mhamann/hdmi-mipi-bridge/production/reports/renders/bottom.png

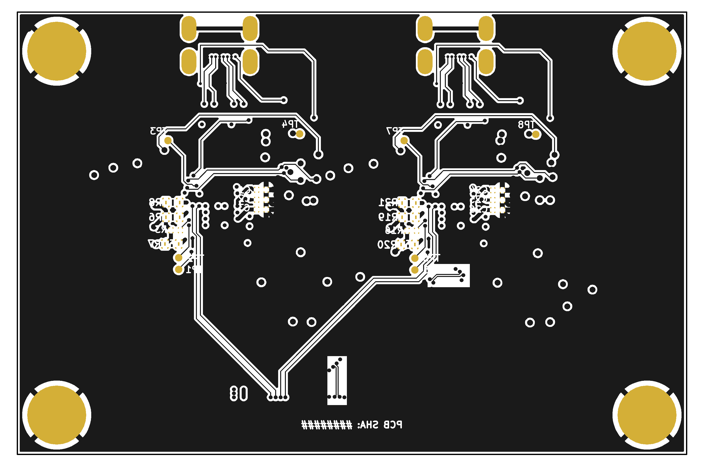
production/reports/renders/bottom.png
