mhamann/hdmi-mipi-bridge/production/reports/renders/ch1_connector_B.Cu.png

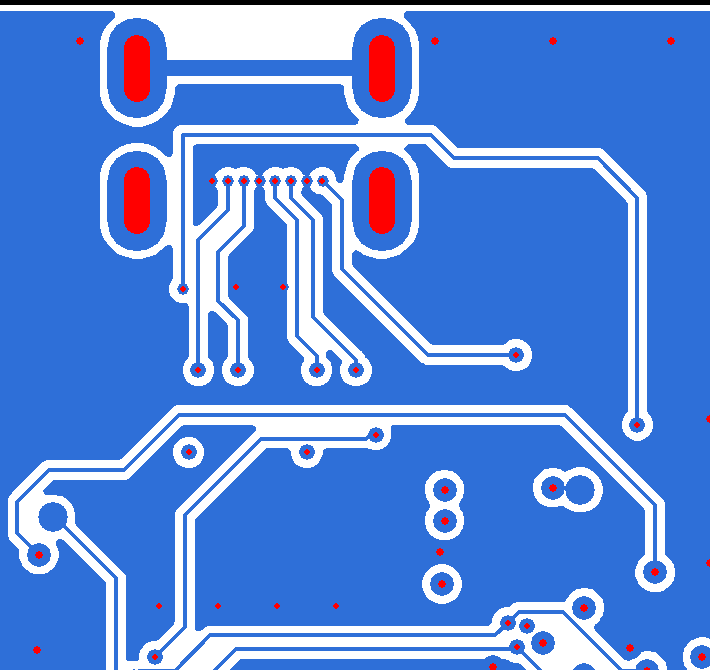
production/reports/renders/ch1_connector_B.Cu.png
