mhamann/hdmi-mipi-bridge/production/reports/renders/ch1_connector_F.Cu.png

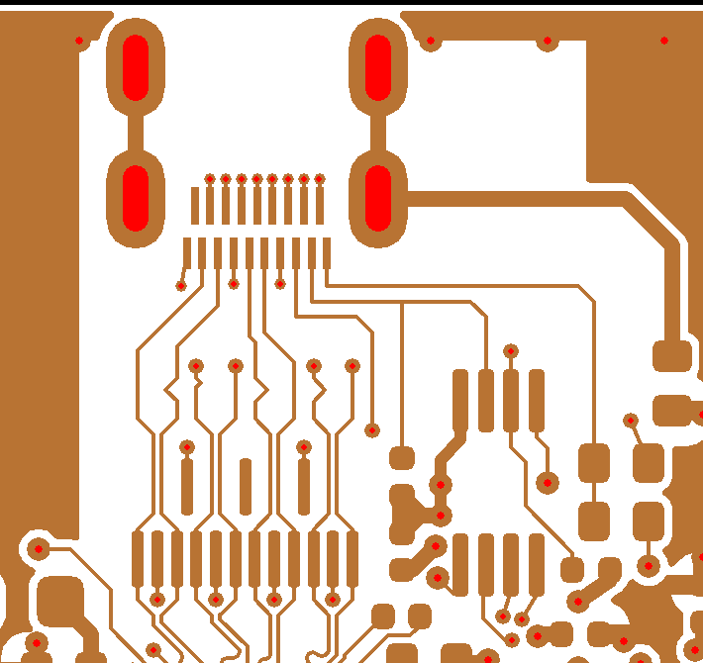
production/reports/renders/ch1_connector_F.Cu.png
