mhamann/hdmi-mipi-bridge/production/reports/renders/ch1_connector_F.Mask.png

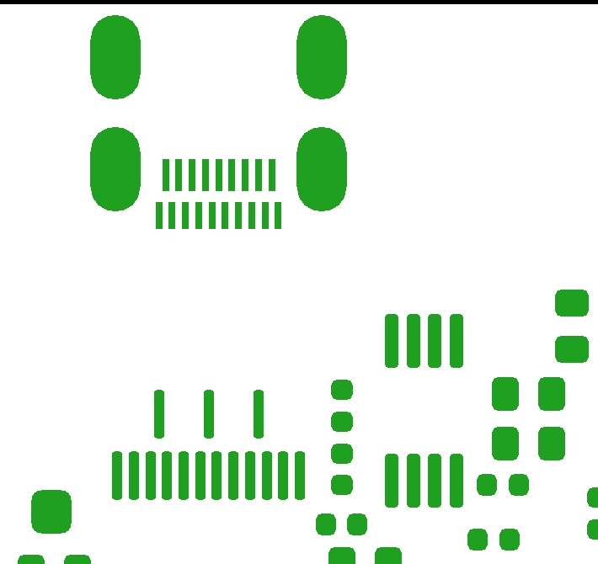
production/reports/renders/ch1_connector_F.Mask.png
