mhamann/hdmi-mipi-bridge/production/reports/renders/ch1_routing_B_labelled.png

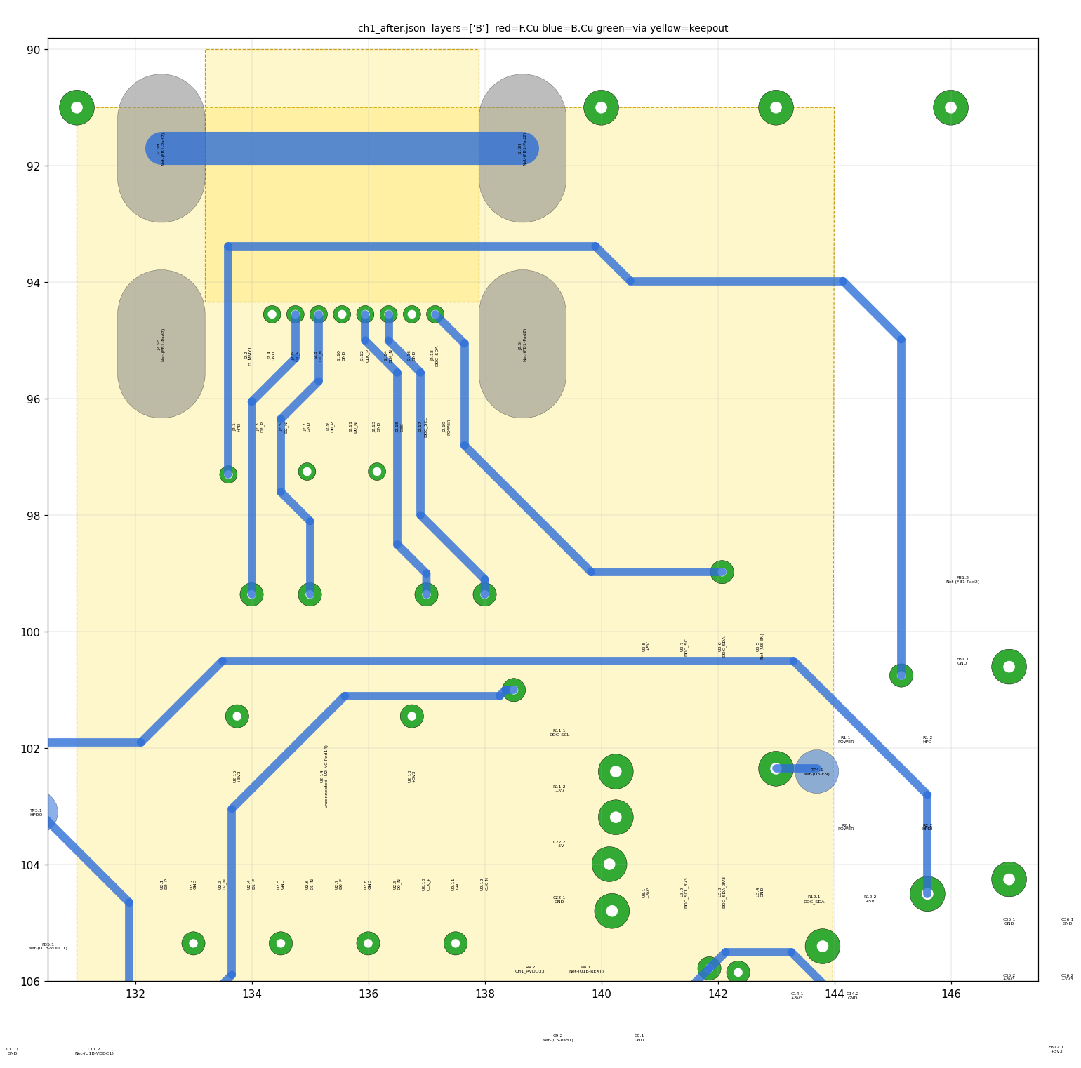
production/reports/renders/ch1_routing_B_labelled.png
