mhamann/hdmi-mipi-bridge/production/reports/renders/ch1_routing_F_labelled.png

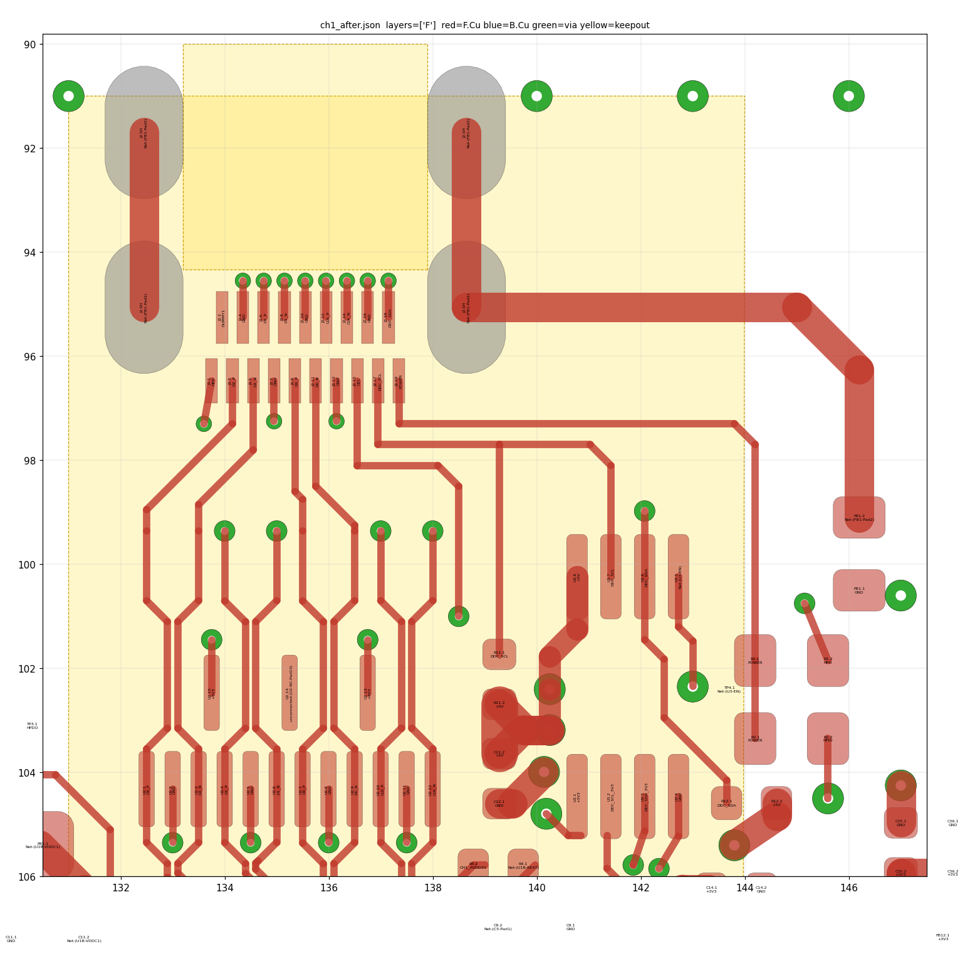
production/reports/renders/ch1_routing_F_labelled.png
