mhamann/hdmi-mipi-bridge/production/reports/renders/top.png

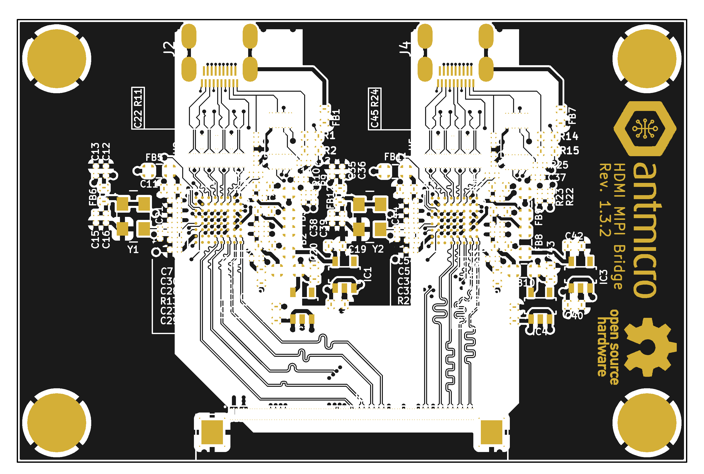
production/reports/renders/top.png
