mhamann/hdmi-mipi-bridge/production/jlcpcb/BOM-hdmi-mipi-bridge.csv

Comment | Designator | Footprint | LCSC Part # | Qty | Manufacturer | MPN | Ordered part | Notes
C_100n_0402 | C1,C2,C3,C12,C14,C15,C22,C24,C25,C26,C27,C28,C29,C30,C31,C32,C33,C34,C35,C37,C38,C45 | C_0402_1005Metric | C85960 | 22 | Murata | GRM155R61H104KE14D | Murata GRM155R61H104KE14D
C_470p_0402 | C4,C5,C6,C7,C47,C48,C49,C50 | C_0402_1005Metric | C106207 | 8 | Yageo | CC0402KRX7R9BB471 | Yageo CC0402KRX7R9BB471 | changed from Walsin 0402B471K250CT (out of stock)
C_4u7_0603 | C8,C9,C10,C11,C51,C52,C53,C54 | C_0603_1608Metric | C329940 | 8 | TDK | C1608X5R1V475KT000E | TDK C1608X5R1V475KT000E | changed from TDK C1608X5R1V475M080AC (out of stock)
C_47p_0402 | C13,C16,C21,C23,C36,C39,C44,C46 | C_0402_1005Metric | C2169042 | 8 | KEMET | C0402C470J5GACTU | KEMET C0402C470J5GACTU
C_10u_0603 | C17,C18,C19,C20,C40,C41,C42,C43 | C_0603_1608Metric | C77044 | 8 | Murata | GRM188R61A106KE69D | Murata GRM188R61A106KE69D
FB_120Z_3A_Murata-BLM18SG_0603 | FB1,FB7 | FB_0603_1608Metric | C113030 | 2 | Murata | BLM18SG121TN1D | Murata BLM18SG121TN1D
FB_1kZ_0.8A_WE-CBF_0805 | FB2,FB3,FB4,FB5,FB8,FB9,FB10,FB11 | FB_0805_2012Metric | C2661448 | 8 | Würth Elektronik | 742792096 | Wurth 742792096
FB_600Z_0.5A_Murata-BLM18AG_0603 | FB6,FB12 | FB_0603_1608Metric | C19330 | 2 | Murata | BLM18AG601SN1D | Murata BLM18AG601SN1D
TLV73325PDBVR | IC1,IC3 | SOT-23-5 | C882825 | 2 | Texas Instruments | TLV73325PDBVR | TI TLV73325PDBVR | reel code of original TLV73325PDBVT
TLV74312PDBVR | IC2,IC4 | SOT-23-5 | C485149 | 2 | Texas Instruments | TLV74312PDBVR | TI TLV74312PDBVR | changed from TLV73312PDBVT (pin-compatible TLV743P, 36 in stock)
HDMI-D_Molex_467651001 | J2,J4 | HDMI_Micro-D_Molex_46765-1xxx | C563878 | 2 | Molex | 467651001 | Molex 467651001 micro-HDMI | NEW: replaces HDMI-A Molex 471511001
Conn_FFC_WE_68715014022 | J6 | Conn_FFC_WE_68715014x22 | C5566958 | 1 | Würth Elektronik | 68715014022 | Wurth 68715014022 | lowest stock on BOM (17)
R_0R_0603 | R1,R2,R5,R6,R7,R8,R14,R15,R18,R19,R20,R21 | R_0603_1608Metric | C512908 | 12 | Bourns | CR0603-J/-000ELF | Bourns CR0603-J/-000ELF
R_10k_0402 | R3,R9,R10,R11,R12,R16,R22,R23,R24,R25 | R_0402_1005Metric | C202396 | 10 | Bourns | CR0402-FX-1002GLF | Bourns CR0402-FX-1002GLF
R_2k_0402 | R4,R17 | R_0402_1005Metric | C4109 | 2 | UNI-ROYAL | 0402WGF2001TCE | UNI-ROYAL 0402WGF2001TCE | JLC basic; changed from Bourns CR0402-FX-2001GLF
R_22R_0402 | R13,R26 | R_0402_1005Metric | C25092 | 2 | UNI-ROYAL | 0402WGF220JTCE | UNI-ROYAL 0402WGF220JTCE | JLC basic; changed from Bourns CR0402-FX-22R0GLF
Spacer_Drill4.25mm_H6mm_SMTSO2560CTJ | SP1,SP2,SP3,SP4 | Spacer_Drill4.25mm_H6mm_SMTSO2560CTJ | C2916361 | 4 | Sinhoo | SMTSO2560CTJ | Sinhoo SMTSO2560CTJ | changed from Wurth 9774060151R; hole now 4.25 mm
TC358743XBG | U1,U4 | BGA-64_8x8_6.0x6.0mm | C3008606 | 2 | Toshiba | TC358743XBG | Toshiba TC358743XBG(EL,NOK) | tape&reel ordering code of TC358743XBG
TPD8S009DSMR | U2,U5 | R-PDSO-N15 | C471873 | 2 | Texas Instruments | TPD8S009DSMR | TI TPD8S009DSMR
PCA9517ADP | U3,U6 | MSOP-8_3x3mm_P0.65mm | C80799 | 2 | NXP | PCA9517ADP,118 | NXP PCA9517ADP,118 | changed from PCA9517ATP (HWSON8, 4 in stock); MSOP-8
Oscillator_27MHz_HELE_SSI027000E3CH | Y1,Y2 | Oscillator_SMD_TXC_7C_5x3.2x1.2mm | C254224 | 2 | HELE (Harmony Electronics) | SSI027000E3CH | HELE SSI027000E3CH | changed from TXC 7C-27.000MBB-T (out of stock)
