mhamann/hdmi-mipi-bridge/production/reports/schematic.pdf

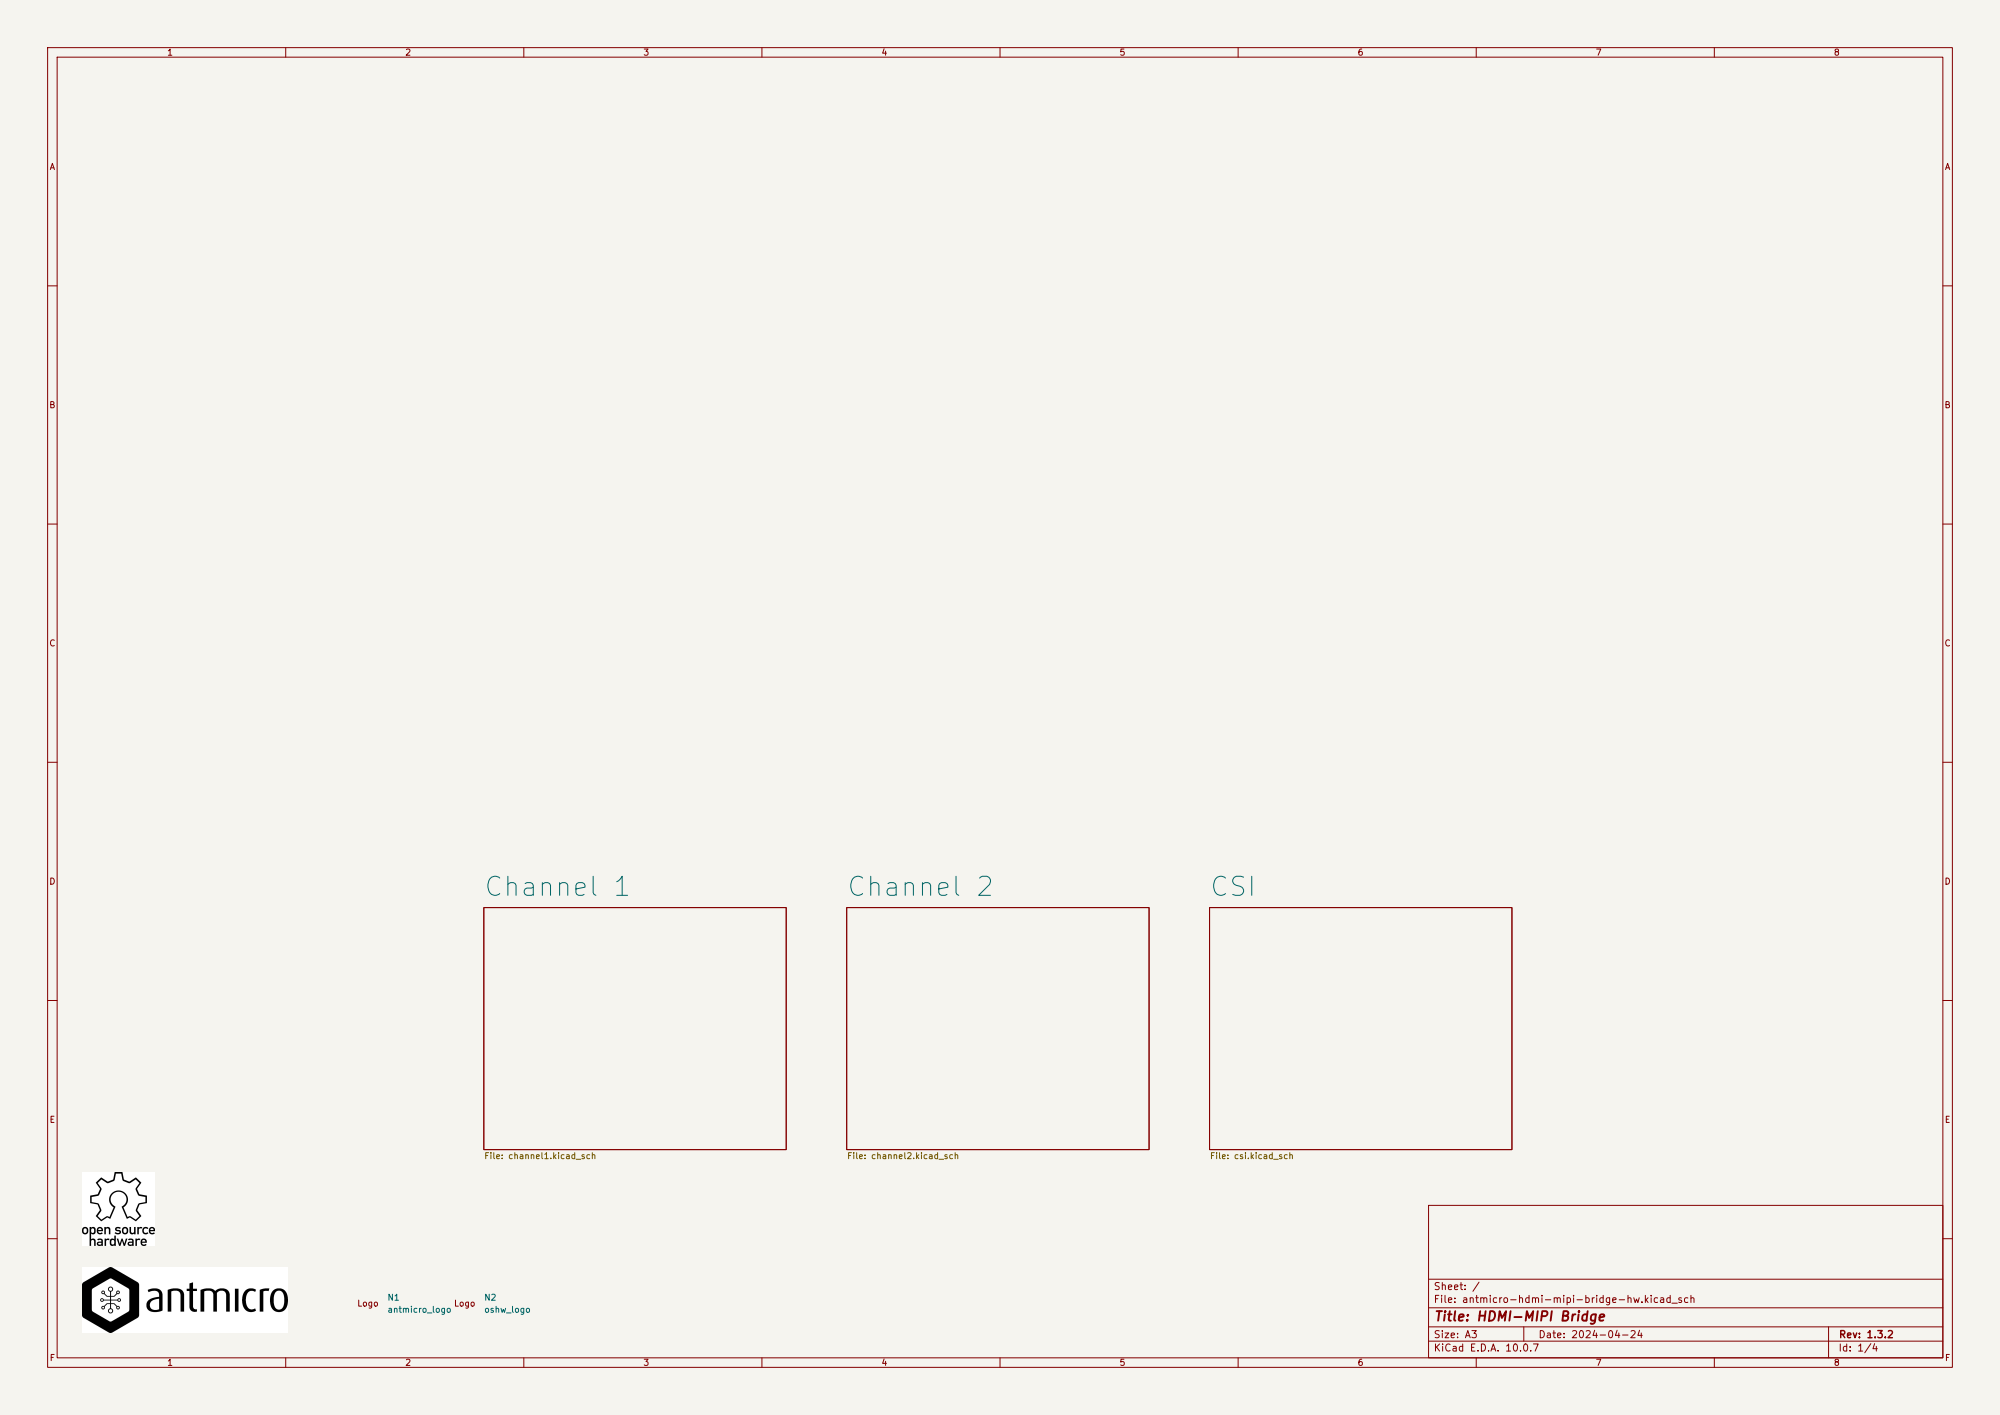
[picture p8: page 1]

Sheet: /
File: antmicro-hdmi-mipi-bridge-hw.kicad_sch
Title: HDMI-MIPI Bridge

Size: A3 | Rev: 1.3.2 | F Date: 2024-04-24
KiCad E.D.A. 10.0.7 | Id: 1/4

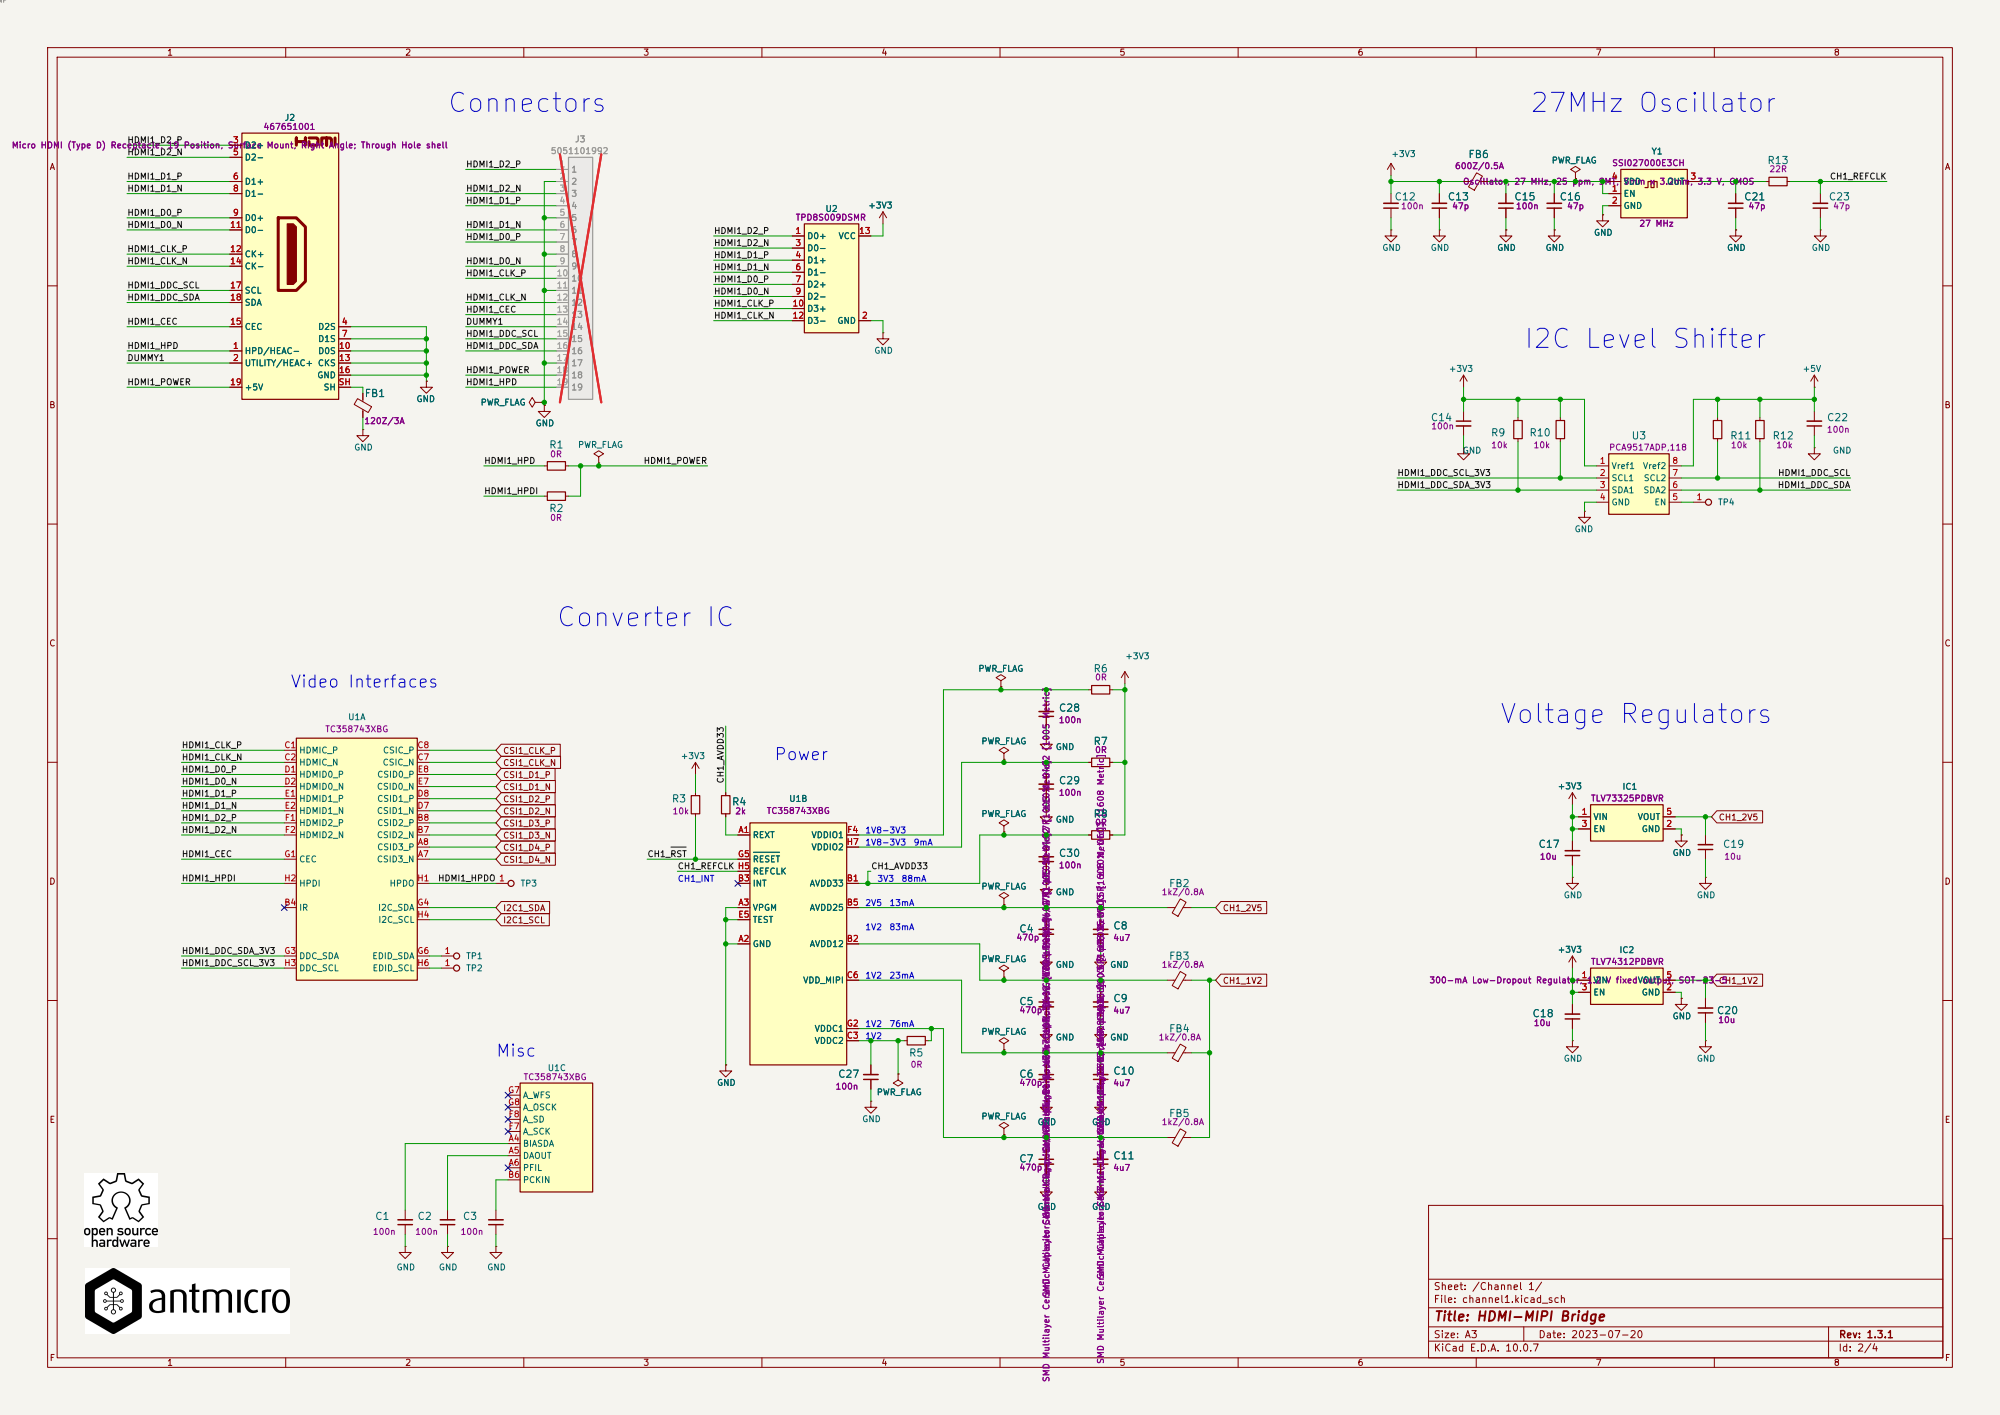
[picture p9: page 2]

PWR_FLAGC4 SMD Multilayer Ceramic Capacitor, General Purpose, 470 pF, 50 V, X7R, ±10%, 0402 [1005 Metric]

GND C5 SMD Multilayer Ceramic Capacitor, General Purpose, 470 pF, 50 V, X7R, ±10%, 0402 [1005 Metric]

300-mA Low-Dropout Regulator, 1.2 V fixed output, SOT-23-5

BIASDA A4 DAOUT A5 PFIL A6 PCKIN B6

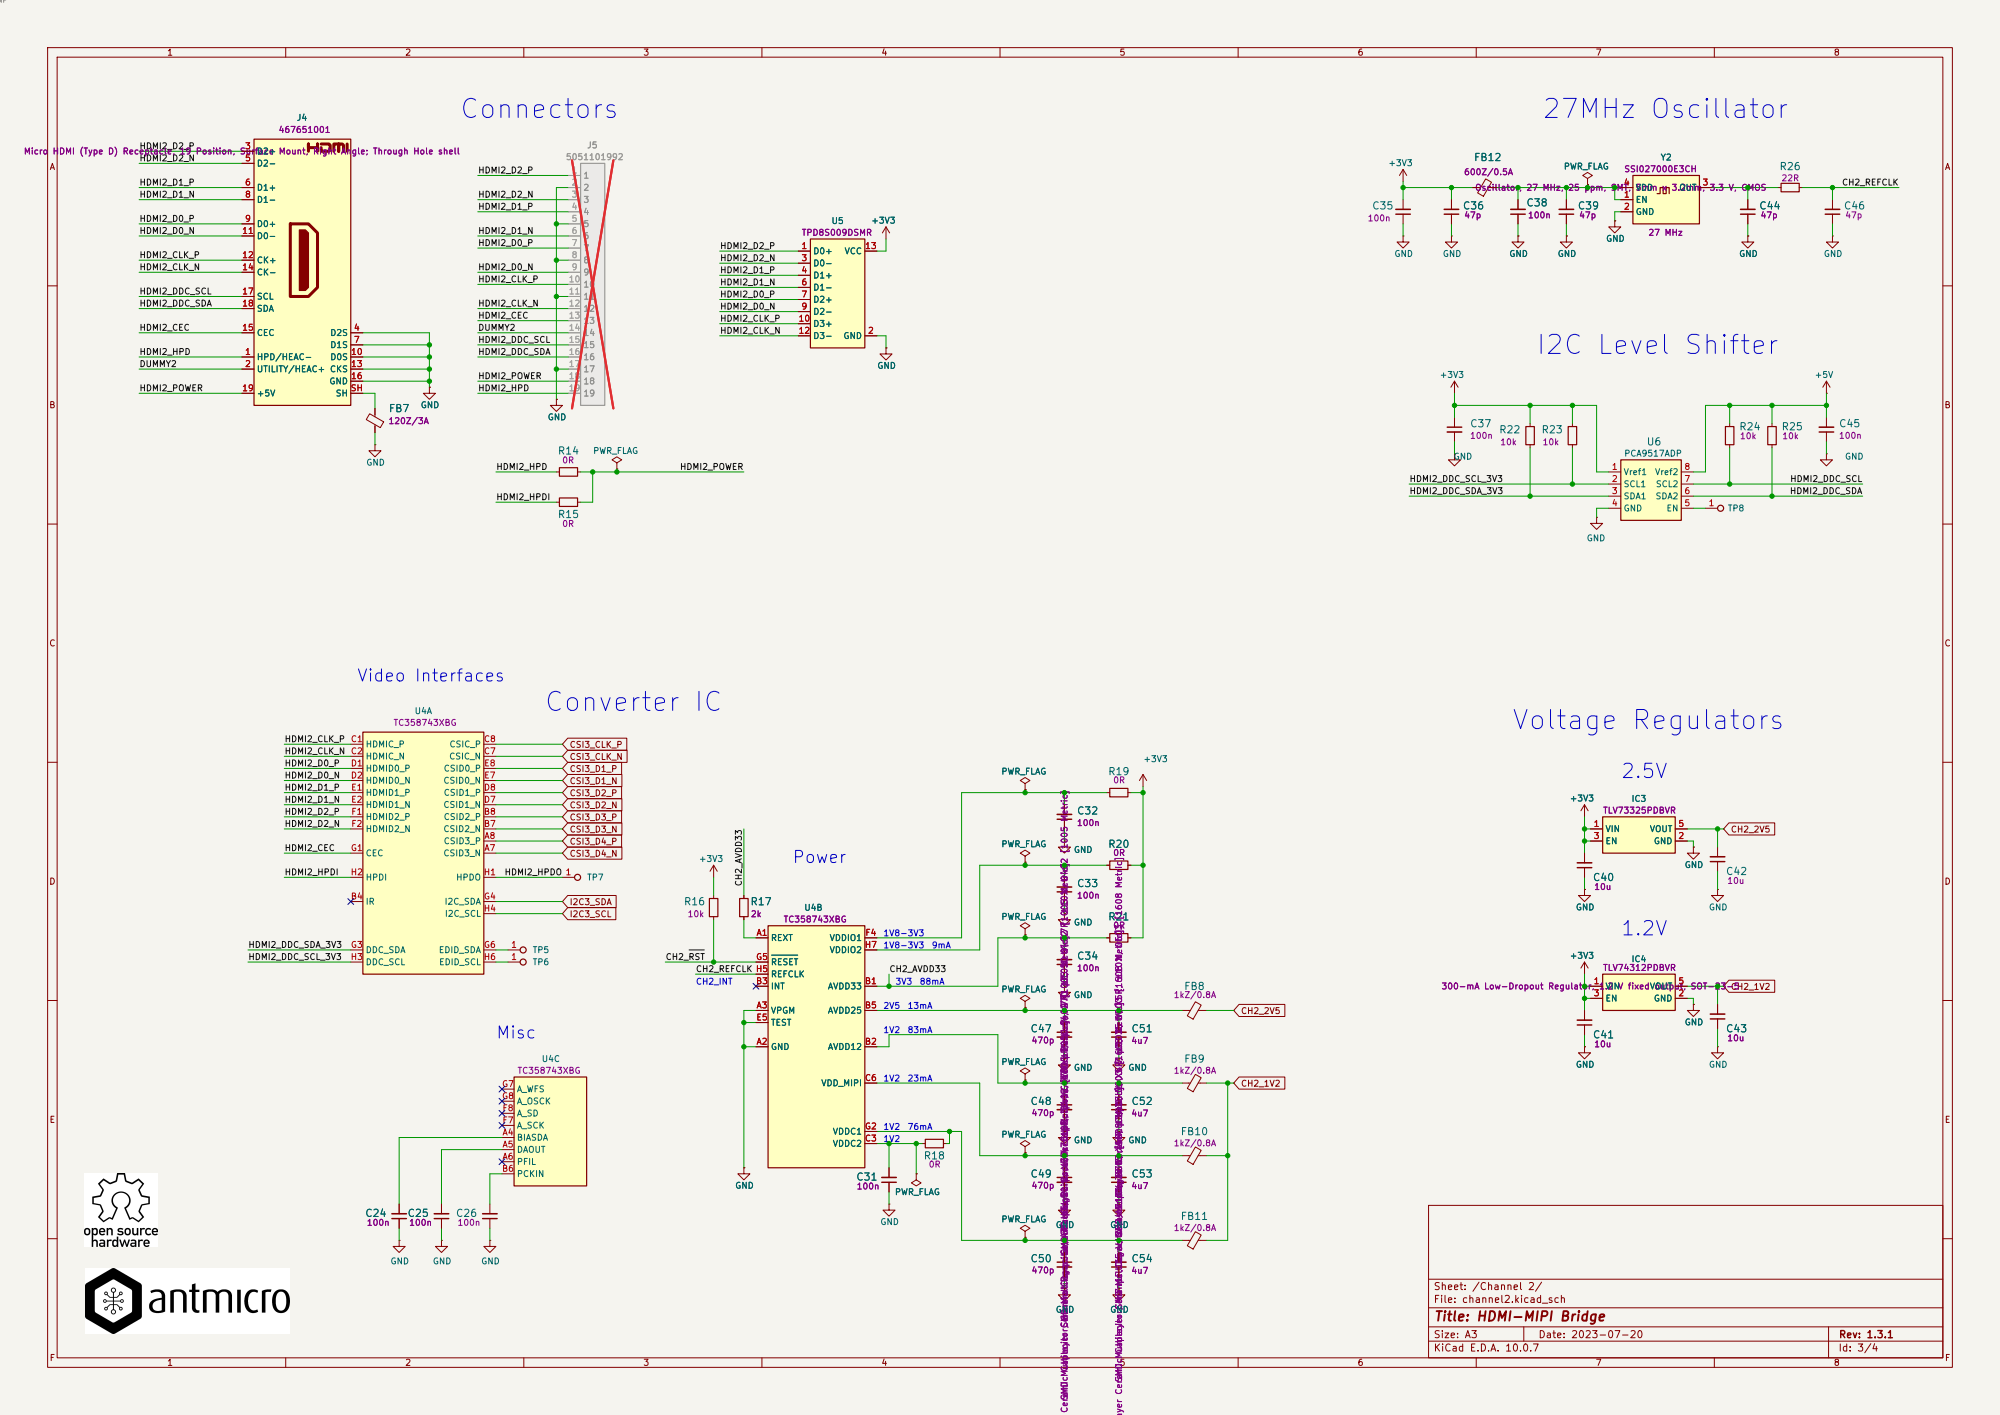
[picture p10: page 3]

J4 Micro HDMI (Type D) Receptacle, 19 Position, Surface Mount, Right Angle; Through Hole shell 467651001

100n C49 SMD Multilayer Ceramic Capacitor, General Purpose, 470 pF, 50 V, X7R, ±10%, 0402 [1005 Metric]
10k C48 SMD Multilayer Ceramic Capacitor, General Purpose, 470 pF, 50 V, X7R, ±10%, 0402 [1005 Metric]

300-mA Low-Dropout Regulator, 1.2 V fixed output, SOT-23-5

100n BIASDA A4 DAOUT A5 PFIL A6 PCKIN B6

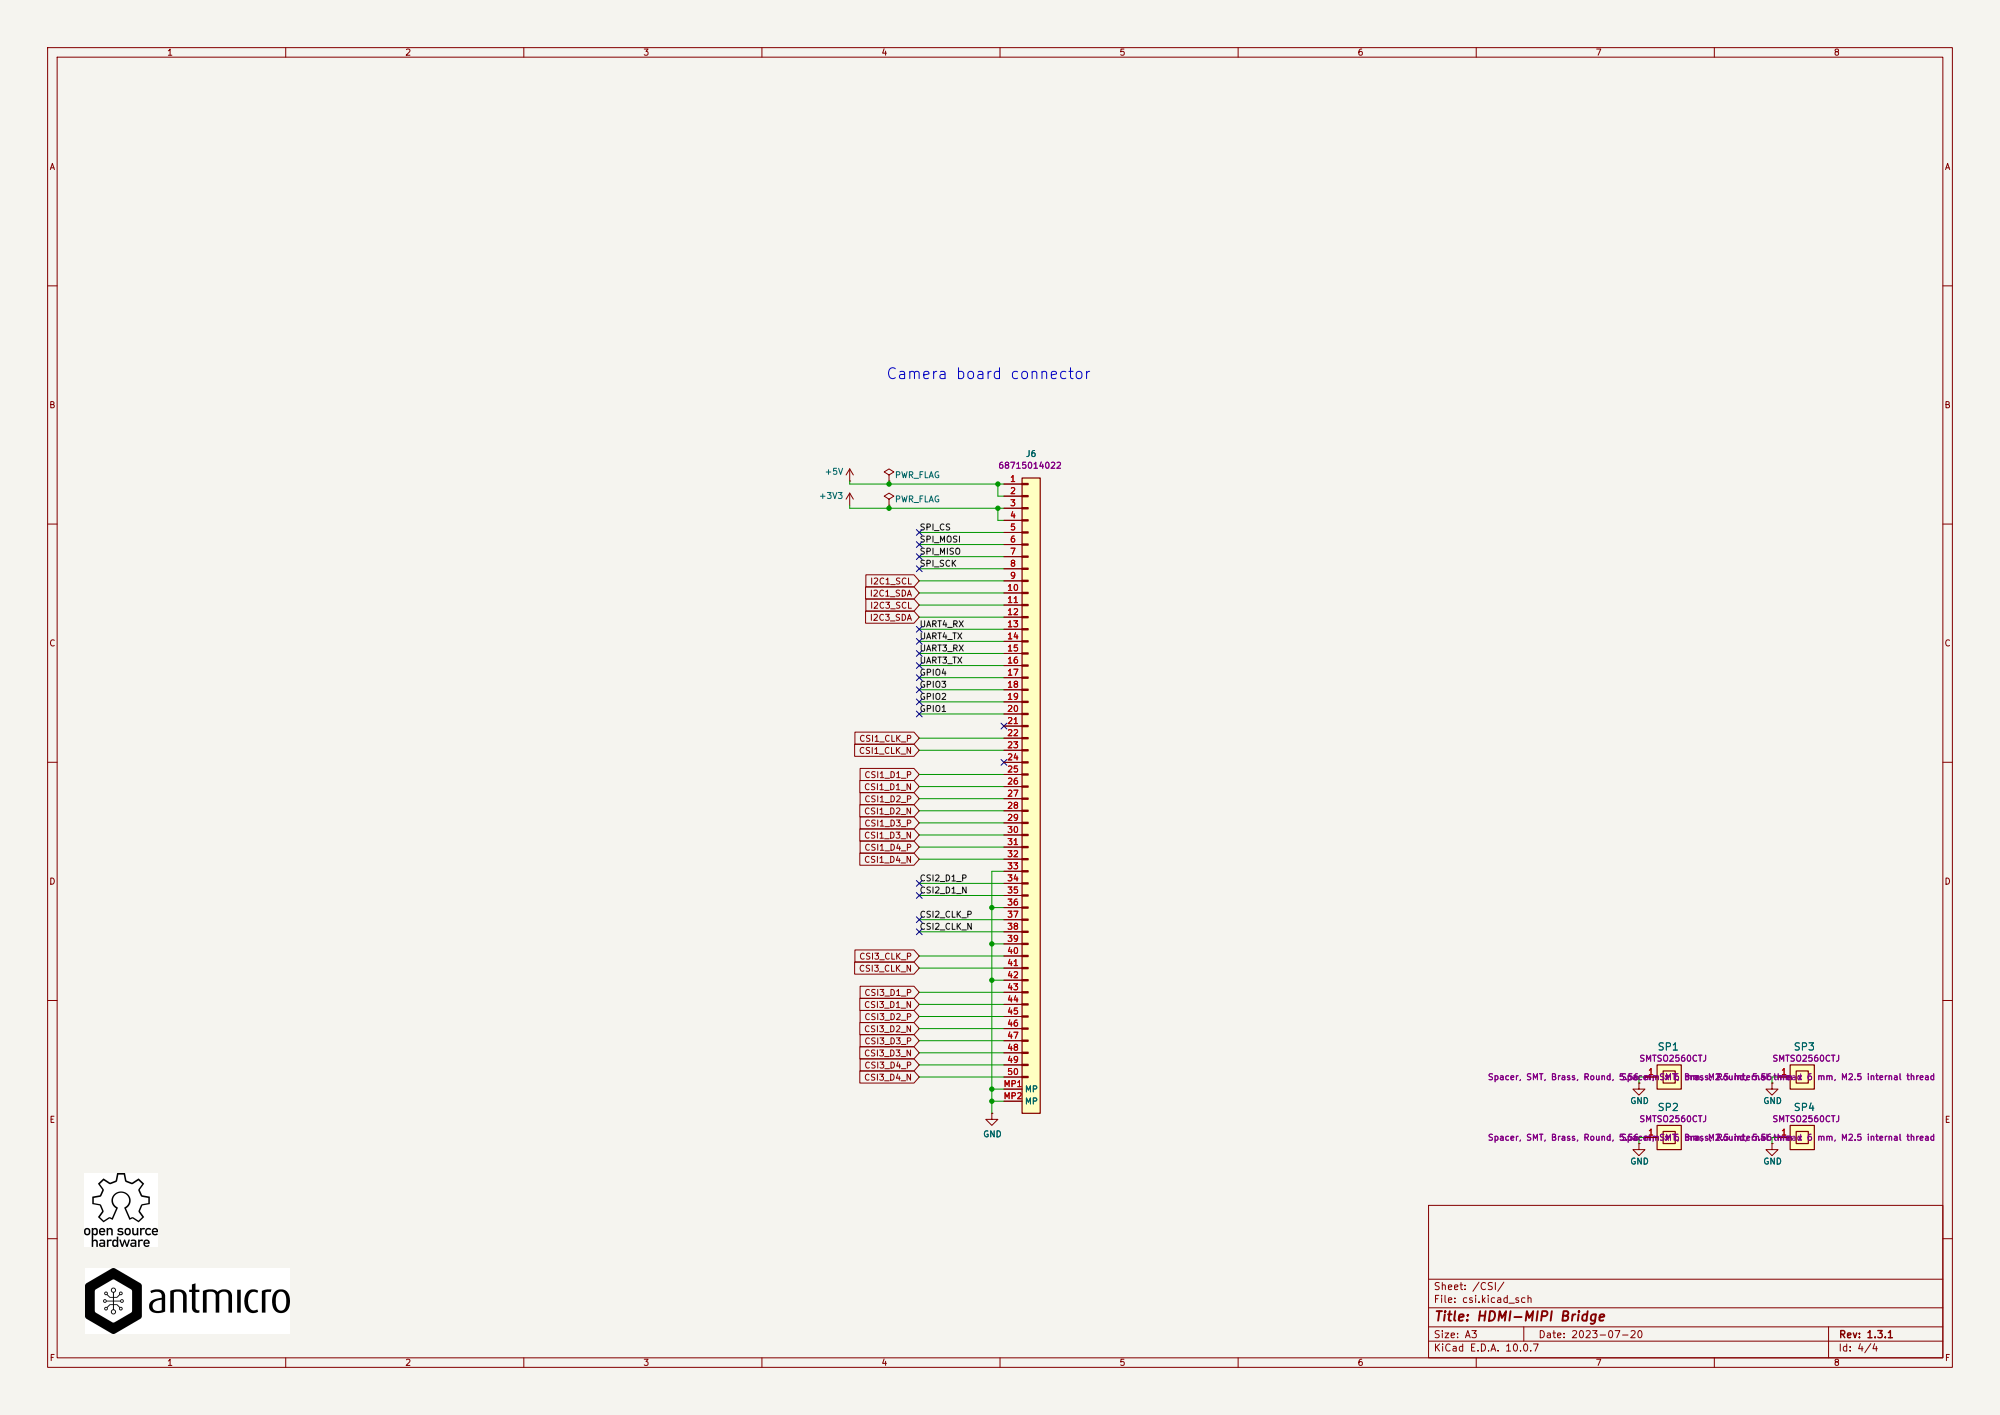
[picture p11: page 4]
