mhamann/hdmi-mipi-bridge/antmicro-hdmi-mipi-bridge-hw.kicad_pcb

## KiCad design antmicro-hdmi-mipi-bridge-hw.kicad_pcb (2026-10-27)

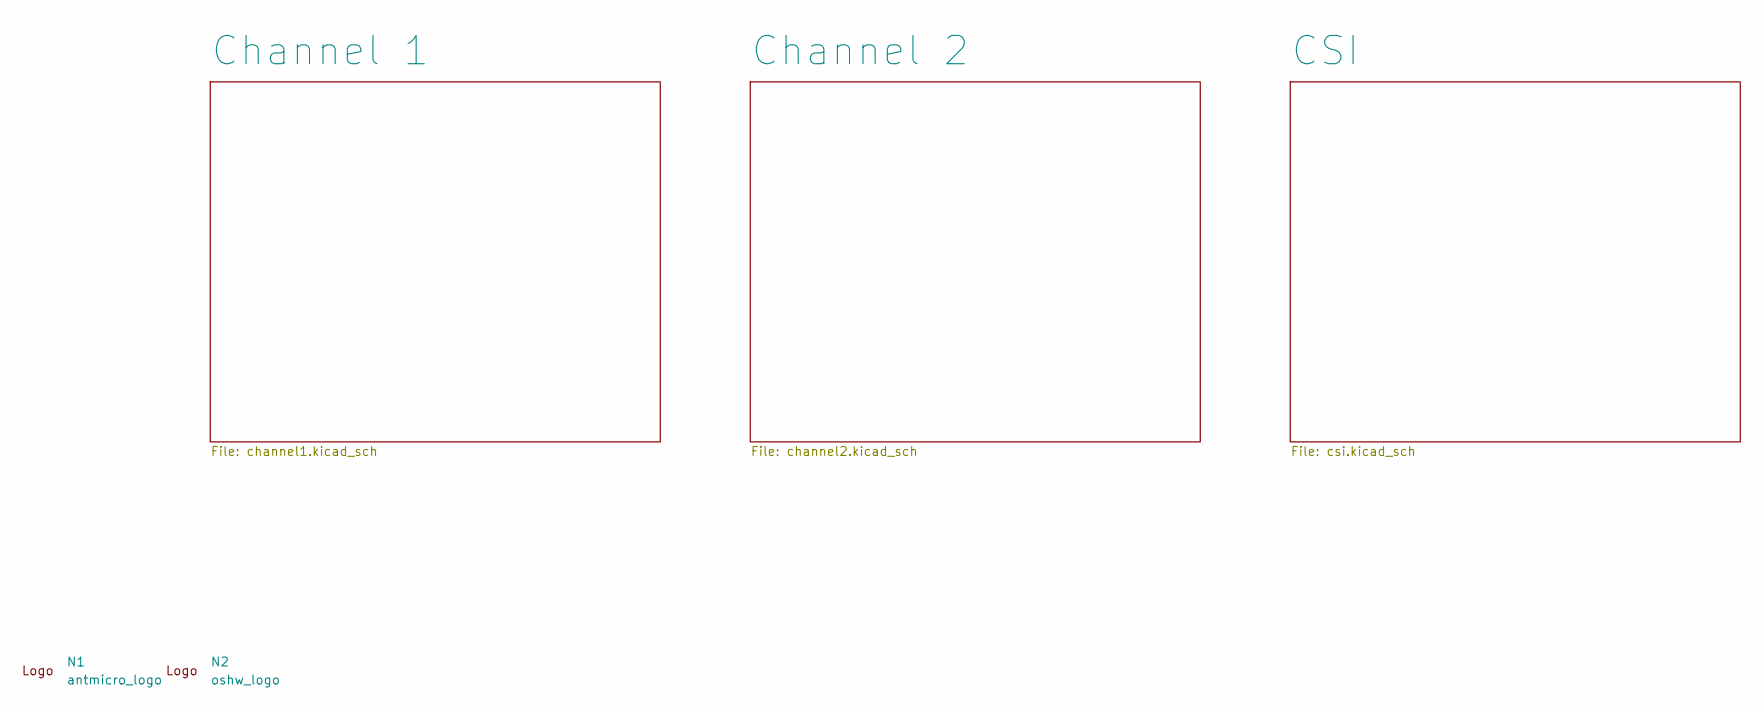
[picture p12: schematic antmicro-hdmi-mipi-bridge-hw.kicad_sch, HDMI-MIPI Bridge]

Parts:
N1: antmicro_logo; antmicro-logo_scaled_20mm_mask
N2: oshw_logo; OSHW-Logo_7.5x8mm_Mask

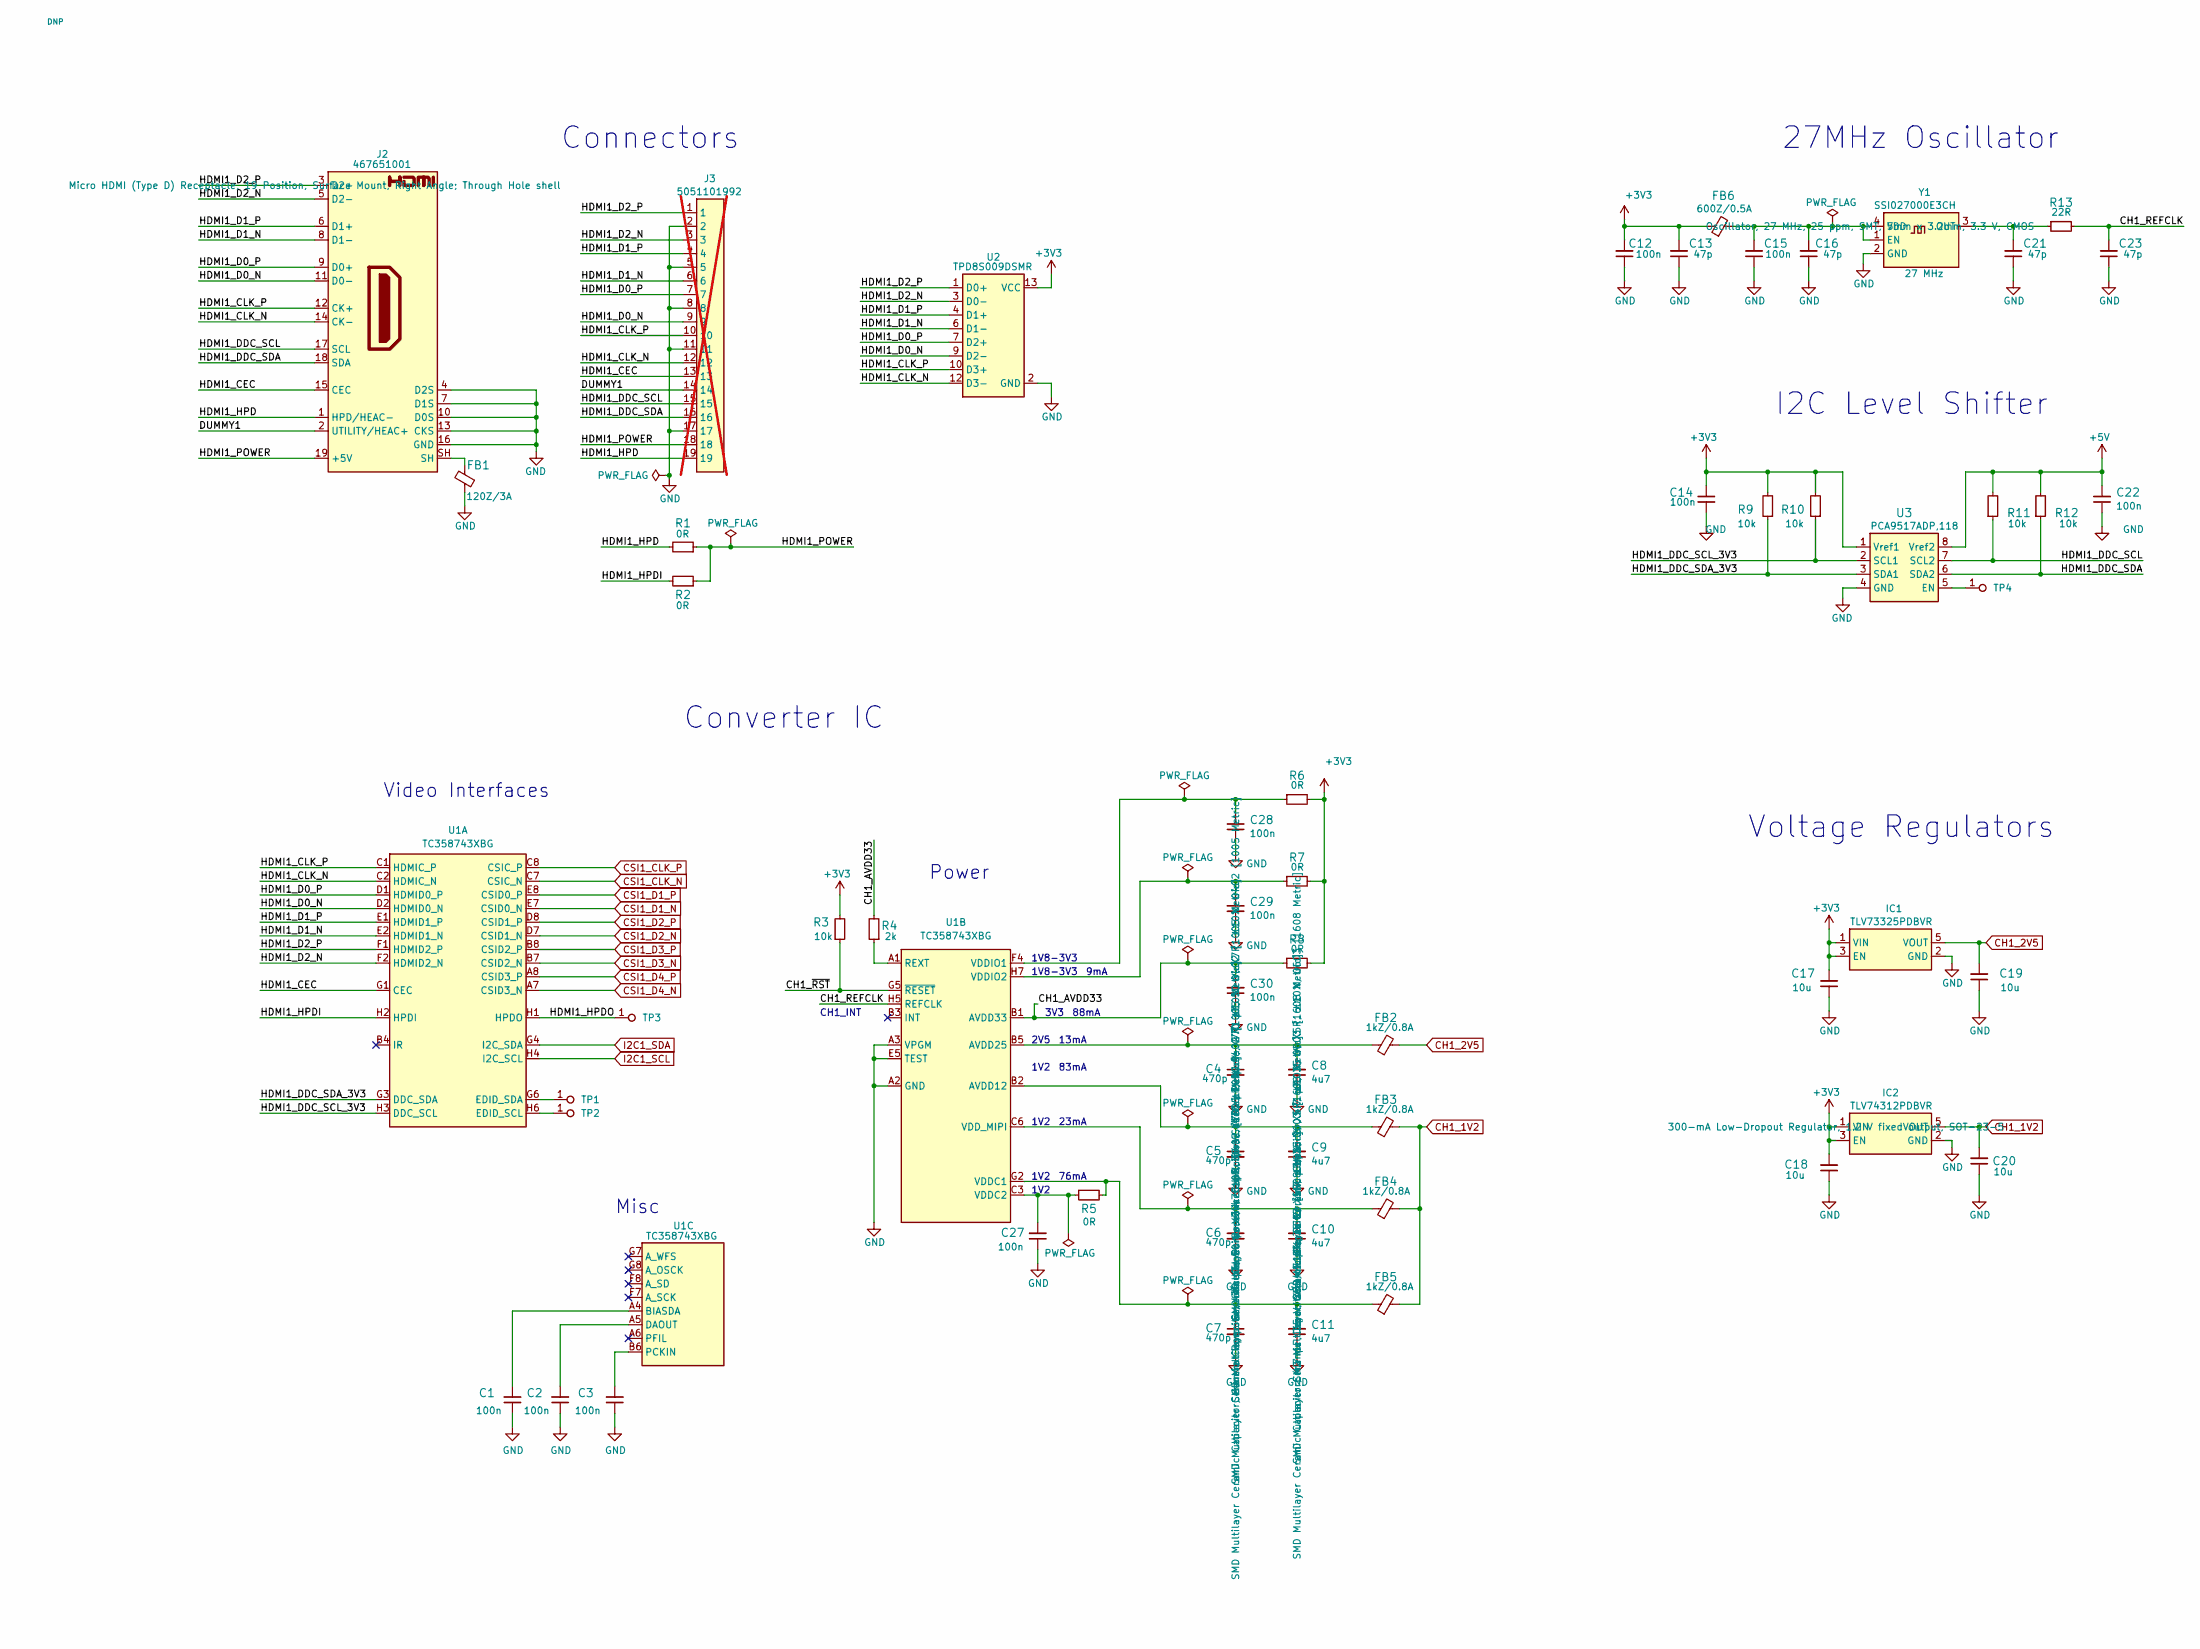
[picture p13: schematic channel1.kicad_sch, HDMI-MIPI Bridge]

Parts:
C1, C2, C3, C12, C14, C15, C22, C27, C28, C29, C30: C_100n_0402; C_0402_1005Metric; Voltage 50V; MPN GRM155R61H104KE14D
C4, C5, C6, C7: C_470p_0402; C_0402_1005Metric; MPN CC0402KRX7R9BB471
C8, C9, C10, C11: C_4u7_0603; C_0603_1608Metric; MPN C1608X5R1V475KT000E
C13, C16, C21, C23: C_47p_0402; C_0402_1005Metric; MPN C0402C470J5GACTU
C17, C18, C19, C20: C_10u_0603; C_0603_1608Metric; MPN GRM188R61A106KE69D
FB1: FB_120Z_3A_Murata-BLM18SG_0603; FB_0603_1608Metric; MPN BLM18SG121TN1D
FB2, FB3, FB4, FB5: FB_1kZ_0.8A_WE-CBF_0805; FB_0805_2012Metric; MPN 742792096
FB6: FB_600Z_0.5A_Murata-BLM18AG_0603; FB_0603_1608Metric; MPN BLM18AG601SN1D
IC1: TLV73325PDBVR; SOT-23-5; MPN TLV73325PDBVR
IC2: TLV74312PDBVR; SOT-23-5; MPN TLV74312PDBVR
J2: HDMI-D_Molex_467651001; HDMI_Micro-D_Molex_46765-1xxx; MPN 467651001
J3: 5051101992; MPN 5051101992; not fitted
R1, R2, R5, R6, R7, R8: R_0R_0603; R_0603_1608Metric; MPN CR0603-J/-000ELF
R3, R9, R10, R11, R12: R_10k_0402; R_0402_1005Metric; Tolerance 1%; MPN CR0402-FX-1002GLF
R4: R_2k_0402; R_0402_1005Metric; Tolerance 1%; MPN 0402WGF2001TCE
R13: R_22R_0402; R_0402_1005Metric; Tolerance 1%; MPN 0402WGF220JTCE
TP1, TP2, TP3, TP4: TP_0.75mm_SMD; TP_SMD_0.75mm
U1: TC358743XBG; BGA-64_8x8_6.0x6.0mm; MPN TC358743XBG
U2: TPD8S009DSMR; R-PDSO-N15; MPN TPD8S009DSMR
U3: PCA9517ADP; MSOP-8_3x3mm_P0.65mm; MPN PCA9517ADP,118
Y1: Oscillator_27MHz_HELE_SSI027000E3CH; Oscillator_SMD_TXC_7C_5x3.2x1.2mm; MPN SSI027000E3CH

Connections:
+3V3: C12.2, C13.2, C14.1, C17.2, C18.2, FB6.1, IC1.1 (VIN), IC1.3 (EN), IC2.1 (VIN), IC2.3 (EN), R3.2, R6.2, R7.2, R8.2, R9.2, R10.2, U2.13 (VCC), U2.15 (VCC), U3.1 (Vref1); also elsewhere on the board
+5V: C22.2, R11.2, R12.2, U3.8 (Vref2); also elsewhere on the board
/Channel 1/CH1_AVDD33: C30.2, R4.2, R8.1, U1.B1 (AVDD33), U1.F3 (AVDD33)
/Channel 1/CH1_REFCLK: C23.2, R13.2, U1.H5 (REFCLK)
/Channel 1/CH1_~RST: R3.1, U1.G5 (~RESET)
/Channel 1/DUMMY1: J2.2 (UTILITY/HEAC+), J3.14
/Channel 1/HDMI1_CEC: J2.15 (CEC), J3.13, U1.G1 (CEC)
/Channel 1/HDMI1_CLK_N: J2.14 (CK-), J3.12, U1.C2 (HDMIC_N), U2.12 (D3-)
/Channel 1/HDMI1_CLK_P: J2.12 (CK+), J3.10, U1.C1 (HDMIC_P), U2.10 (D3+)
/Channel 1/HDMI1_D0_N: J2.11 (D0-), J3.9, U1.D2 (HDMID0_N), U2.9 (D2-)
/Channel 1/HDMI1_D0_P: J2.9 (D0+), J3.7, U1.D1 (HDMID0_P), U2.7 (D2+)
/Channel 1/HDMI1_D1_N: J2.8 (D1-), J3.6, U1.E2 (HDMID1_N), U2.6 (D1-)
/Channel 1/HDMI1_D1_P: J2.6 (D1+), J3.4, U1.E1 (HDMID1_P), U2.4 (D1+)
/Channel 1/HDMI1_D2_N: J2.5 (D2-), J3.3, U1.F2 (HDMID2_N), U2.3 (D0-)
/Channel 1/HDMI1_D2_P: J2.3 (D2+), J3.1, U1.F1 (HDMID2_P), U2.1 (D0+)
/Channel 1/HDMI1_DDC_SCL: J2.17 (SCL), J3.15, R11.1, U3.7 (SCL2)
/Channel 1/HDMI1_DDC_SCL_3V3: R10.1, U1.H3 (DDC_SCL), U3.2 (SCL1)
/Channel 1/HDMI1_DDC_SDA: J2.18 (SDA), J3.16, R12.1, U3.6 (SDA2)
/Channel 1/HDMI1_DDC_SDA_3V3: R9.1, U1.G3 (DDC_SDA), U3.3 (SDA1)
/Channel 1/HDMI1_HPD: J2.1 (HPD/HEAC-), J3.19, R1.2
/Channel 1/HDMI1_HPDI: R2.2, U1.H2 (HPDI)
/Channel 1/HDMI1_HPDO: TP3.1, U1.H1 (HPDO)
/Channel 1/HDMI1_POWER: J2.19 (+5V), J3.18, R1.1, R2.1
CH1_1V2: C20.2, FB3.2, FB4.2, FB5.2, IC2.5 (VOUT)
CH1_2V5: C19.2, FB2.2, IC1.5 (VOUT)
CSI1_CLK_N: U1.C7 (CSIC_N); also elsewhere on the board
CSI1_CLK_P: U1.C8 (CSIC_P); also elsewhere on the board
CSI1_D1_N: U1.E7 (CSID0_N); also elsewhere on the board
CSI1_D1_P: U1.E8 (CSID0_P); also elsewhere on the board
CSI1_D2_N: U1.D7 (CSID1_N); also elsewhere on the board
CSI1_D2_P: U1.D8 (CSID1_P); also elsewhere on the board
CSI1_D3_N: U1.B7 (CSID2_N); also elsewhere on the board
CSI1_D3_P: U1.B8 (CSID2_P); also elsewhere on the board
CSI1_D4_N: U1.A7 (CSID3_N); also elsewhere on the board
CSI1_D4_P: U1.A8 (CSID3_P); also elsewhere on the board
GND: C1.1, C2.1, C3.1, C4.2, C5.2, C6.2, C7.2, C8.1, C9.1, C10.1, C11.1, C12.1, C13.1, C14.2, C15.1, C16.1, C17.1, C18.1, C19.1, C20.1, C21.1, C22.1, C23.1, C27.1, C28.1, C29.1, C30.1, FB1.1, IC1.2 (GND), IC2.2 (GND), J2.4 (D2S), J2.7 (D1S), J2.10 (D0S), J2.13 (CKS), J2.16 (GND), J3.2, J3.5, J3.8, J3.11, J3.17, U1.A2 (GND), U1.A3 (VPGM), U1.C4 (GND), U1.C5 (GND), U1.D4 (GND), U1.D5 (GND), U1.D6 (GND), U1.E3 (GND), U1.E4 (GND), U1.E5 (TEST), U1.E6 (GND), U1.H8 (GND), U2.2 (GND), U2.5 (GND), U2.8 (GND), U2.11 (GND), U3.4 (GND), Y1.2 (GND); also elsewhere on the board
I2C1_SCL: U1.H4 (I2C_SCL); also elsewhere on the board
I2C1_SDA: U1.G4 (I2C_SDA); also elsewhere on the board
unnamed: C5.1, C9.2, FB3.1, U1.B2 (AVDD12), U1.D3 (AVDD12)
unnamed: C6.1, C10.2, FB4.1, U1.C6 (VDD_MIPI), U1.F6 (VDD_MIPI)
unnamed: C27.2, R5.1, U1.C3 (VDDC2), U1.F5 (VDDC2)
unnamed: FB1.2, J2.SH
unnamed: TP2.1, U1.H6 (EDID_SCL)
unnamed: TP1.1, U1.G6 (EDID_SDA)
unnamed: C4.1, C8.2, FB2.1, U1.B5 (AVDD25)
unnamed: R4.1, U1.A1 (REXT)
unnamed: C7.1, C11.2, FB5.1, R5.2, U1.G2 (VDDC1)
unnamed: C28.2, R6.1, U1.F4 (VDDIO1)
unnamed: C29.2, R7.1, U1.H7 (VDDIO2)
unnamed: C1.2, U1.A4 (BIASDA)
unnamed: C2.2, U1.A5 (DAOUT)
unnamed: C3.2, U1.B6 (PCKIN)
unnamed: TP4.1, U3.5 (EN)
unnamed: C15.2, C16.2, FB6.2, Y1.1 (EN), Y1.4 (VDD)
unnamed: C21.2, R13.1, Y1.3 (OUT)

Notes on the sheet:
Video Interfaces
88mA
Converter IC
1V2
76mA
1V8-3V3
I2C Level Shifter
9mA
2V5
Connectors
13mA
CH1_INT
Voltage Regulators
3V3
27MHz Oscillator
Power
23mA
Misc
83mA

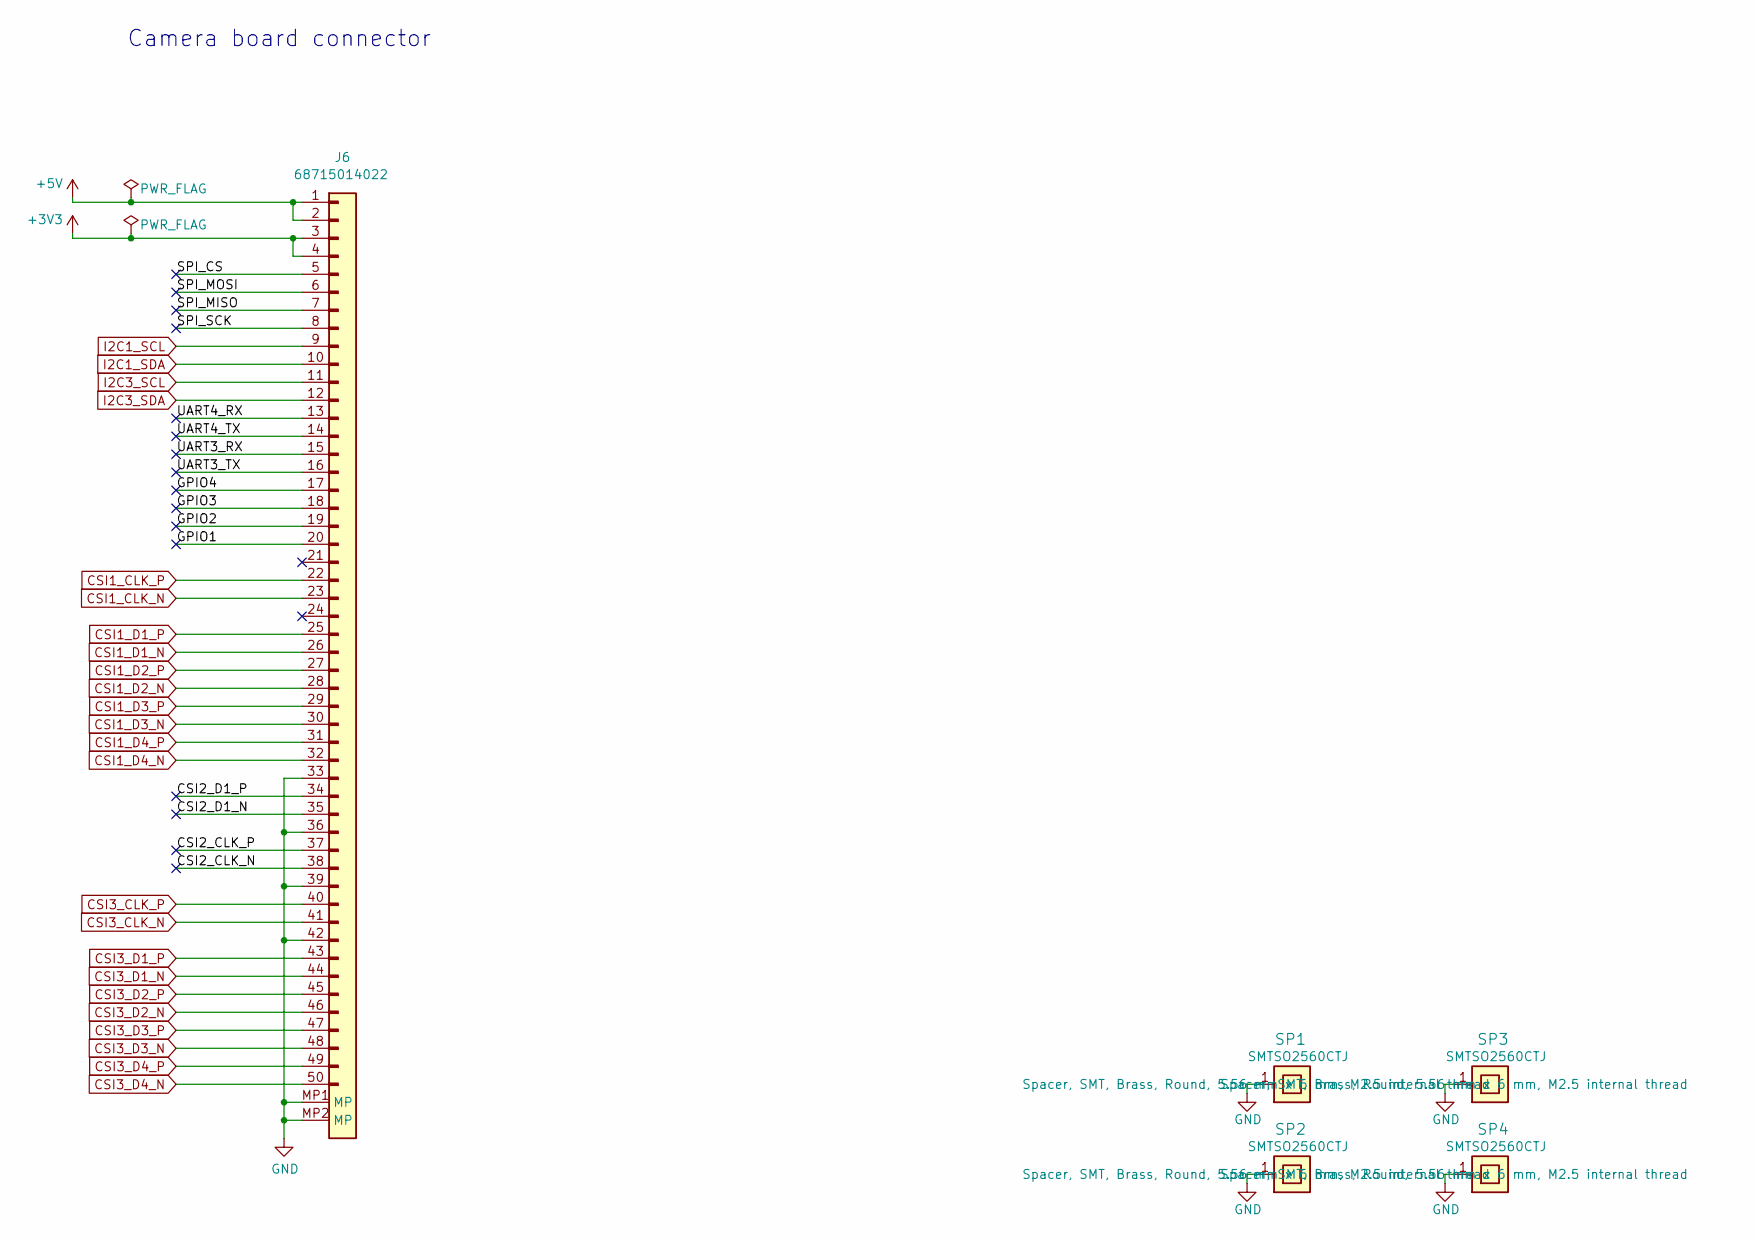
[picture p14: schematic csi.kicad_sch, HDMI-MIPI Bridge]

Parts:
J6: Conn_FFC_WE_68715014022; Conn_FFC_WE_68715014x22; MPN 68715014022
SP1, SP2, SP3, SP4: Spacer_Drill4.25mm_H6mm_SMTSO2560CTJ; MPN SMTSO2560CTJ

Connections:
+3V3: J6.3, J6.4; also elsewhere on the board
+5V: J6.1, J6.2; also elsewhere on the board
/CSI/CSI2_CLK_N: J6.38
/CSI/CSI2_CLK_P: J6.37
/CSI/CSI2_D1_N: J6.35
/CSI/CSI2_D1_P: J6.34
/CSI/GPIO1: J6.20
/CSI/GPIO2: J6.19
/CSI/GPIO3: J6.18
/CSI/GPIO4: J6.17
/CSI/SPI_CS: J6.5
/CSI/SPI_MISO: J6.7
/CSI/SPI_MOSI: J6.6
/CSI/SPI_SCK: J6.8
/CSI/UART3_RX: J6.15
/CSI/UART3_TX: J6.16
/CSI/UART4_RX: J6.13
/CSI/UART4_TX: J6.14
CSI1_CLK_N: J6.23; also elsewhere on the board
CSI1_CLK_P: J6.22; also elsewhere on the board
CSI1_D1_N: J6.26; also elsewhere on the board
CSI1_D1_P: J6.25; also elsewhere on the board
CSI1_D2_N: J6.28; also elsewhere on the board
CSI1_D2_P: J6.27; also elsewhere on the board
CSI1_D3_N: J6.30; also elsewhere on the board
CSI1_D3_P: J6.29; also elsewhere on the board
CSI1_D4_N: J6.32; also elsewhere on the board
CSI1_D4_P: J6.31; also elsewhere on the board
CSI3_CLK_N: J6.41; also elsewhere on the board
CSI3_CLK_P: J6.40; also elsewhere on the board
CSI3_D1_N: J6.44; also elsewhere on the board
CSI3_D1_P: J6.43; also elsewhere on the board
CSI3_D2_N: J6.46; also elsewhere on the board
CSI3_D2_P: J6.45; also elsewhere on the board
CSI3_D3_N: J6.48; also elsewhere on the board
CSI3_D3_P: J6.47; also elsewhere on the board
CSI3_D4_N: J6.50; also elsewhere on the board
CSI3_D4_P: J6.49; also elsewhere on the board
GND: J6.33, J6.36, J6.39, J6.42, J6.MP1 (MP), J6.MP2 (MP), SP1.1, SP2.1, SP3.1, SP4.1; also elsewhere on the board
I2C1_SCL: J6.9; also elsewhere on the board
I2C1_SDA: J6.10; also elsewhere on the board
I2C3_SCL: J6.11; also elsewhere on the board
I2C3_SDA: J6.12; also elsewhere on the board

Notes on the sheet:
Camera board connector

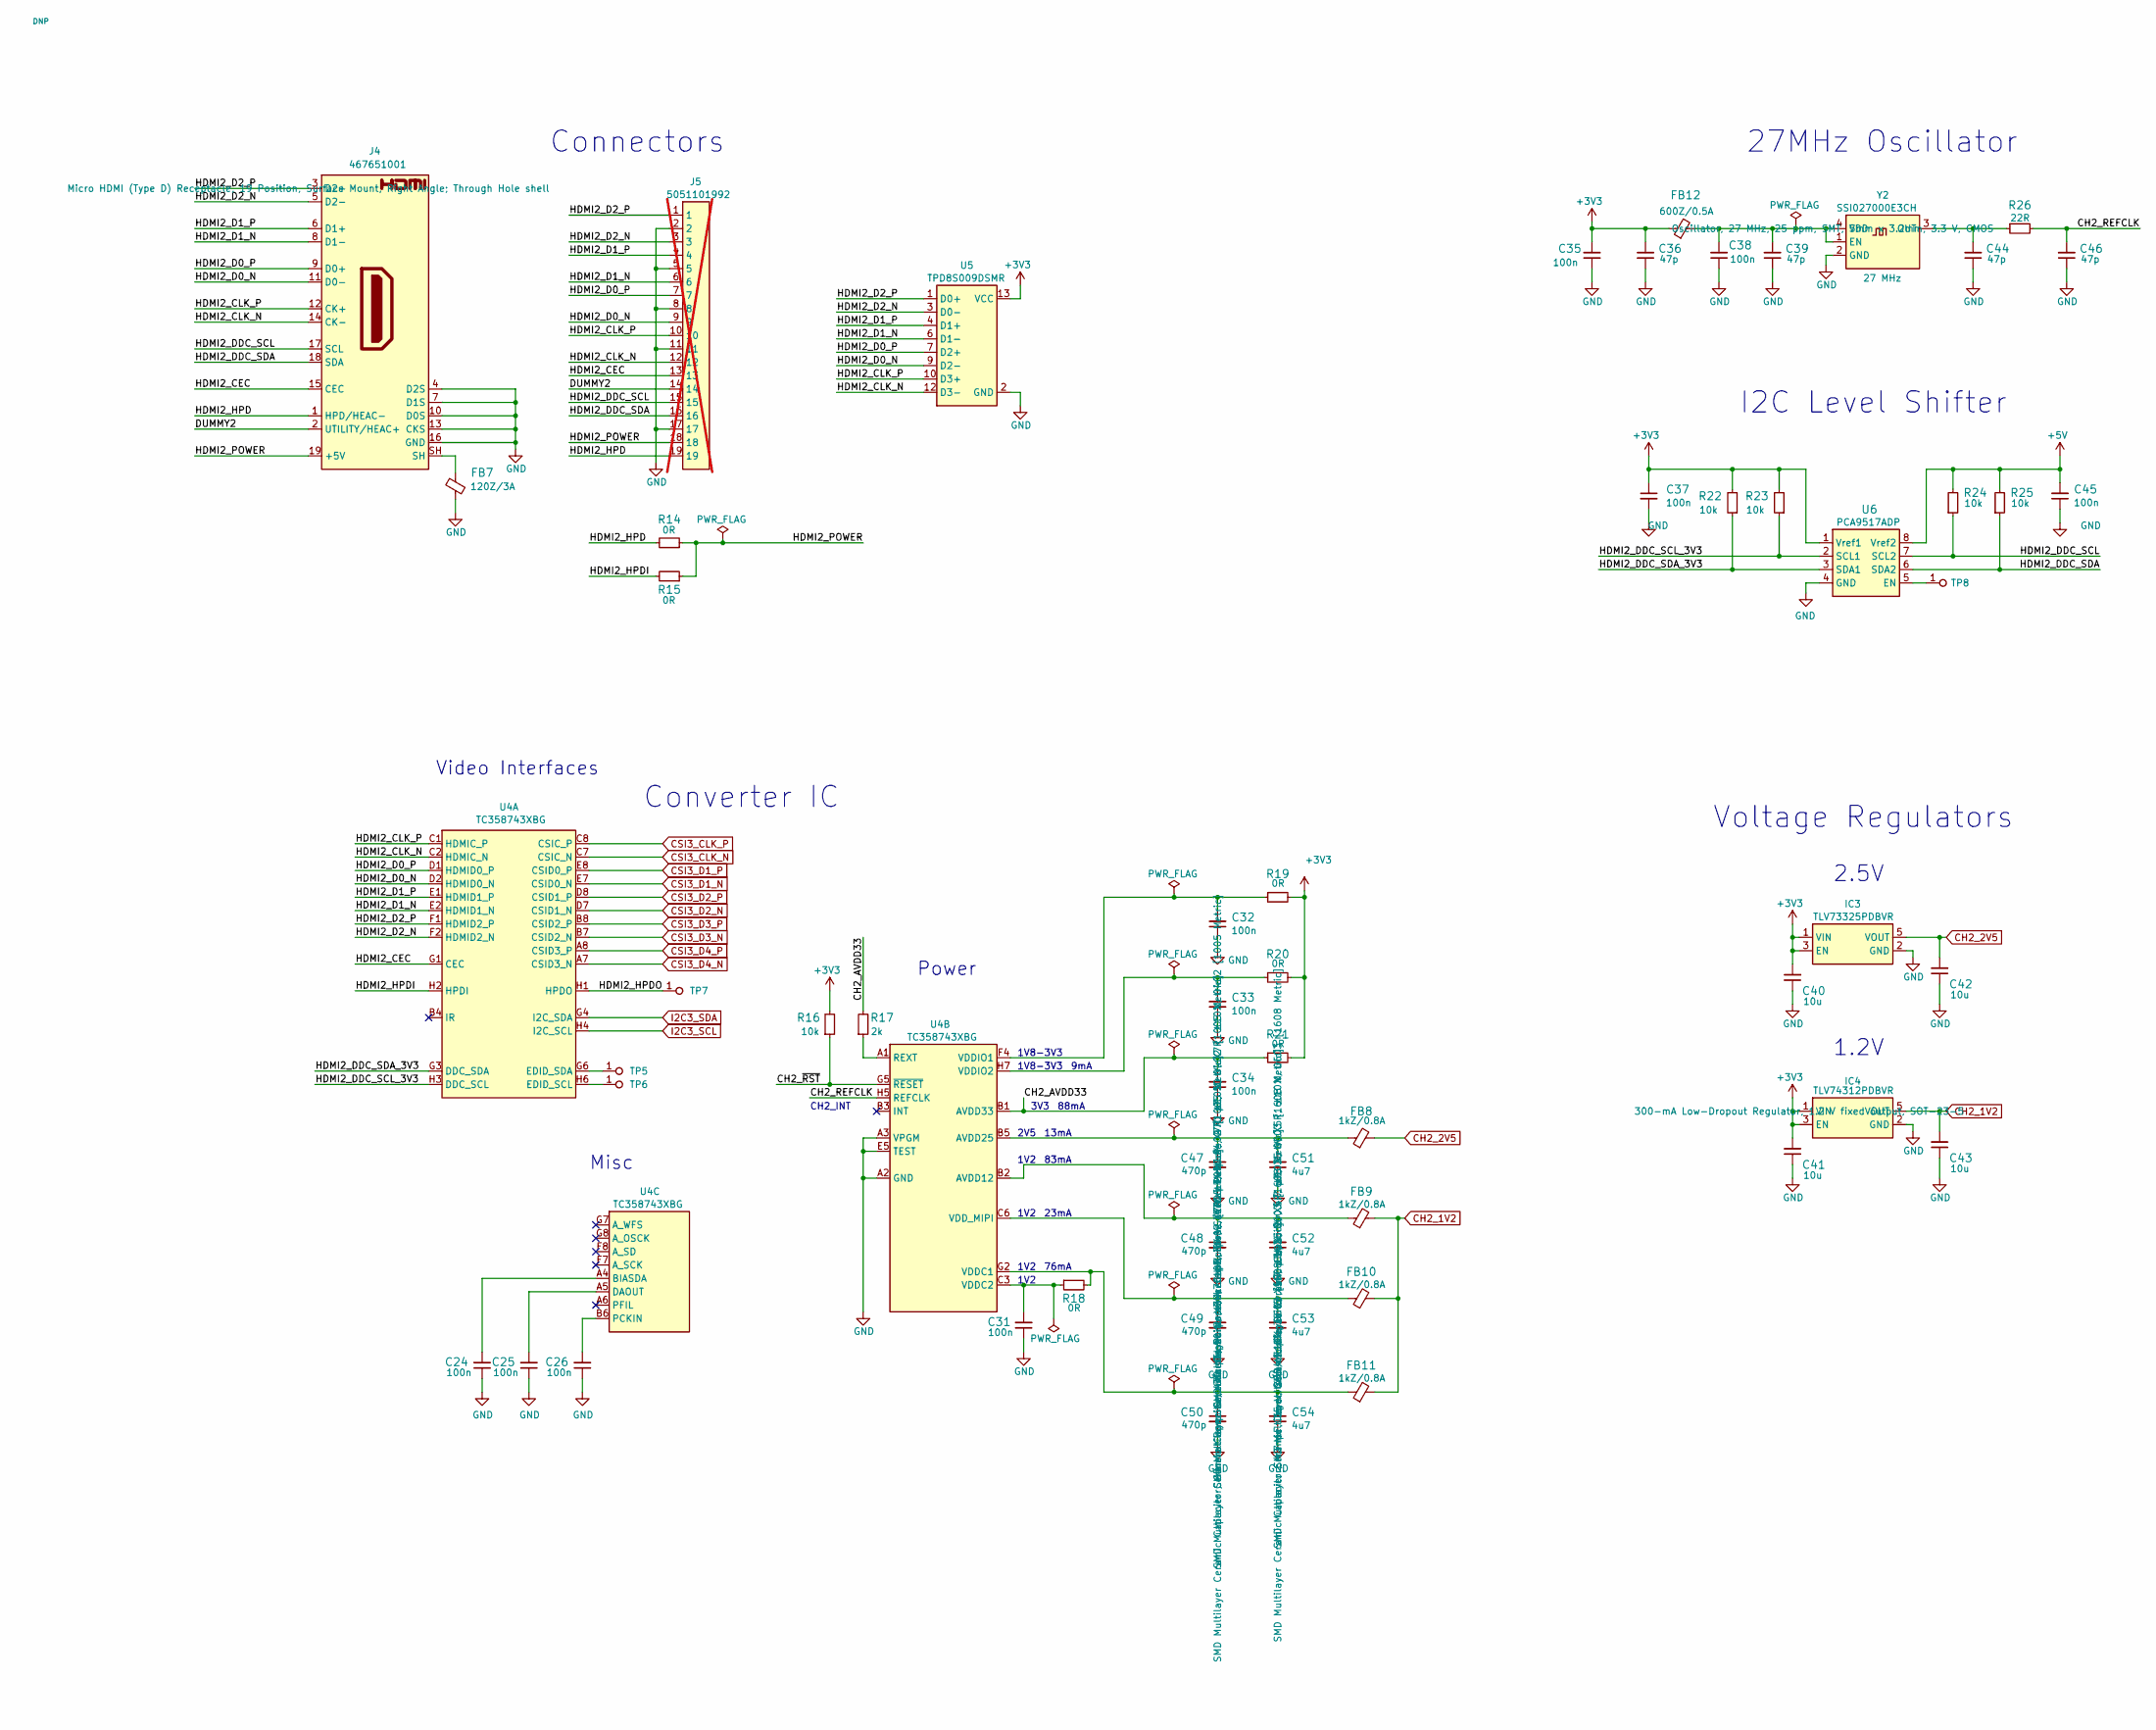
[picture p15: schematic channel2.kicad_sch, HDMI-MIPI Bridge]

Parts:
C24, C25, C26, C31, C32, C33, C34, C35, C37, C38, C45: C_100n_0402; C_0402_1005Metric; Voltage 50V; MPN GRM155R61H104KE14D
C36, C39, C44, C46: C_47p_0402; C_0402_1005Metric; MPN C0402C470J5GACTU
C40, C41, C42, C43: C_10u_0603; C_0603_1608Metric; MPN GRM188R61A106KE69D
C47, C48, C49, C50: C_470p_0402; C_0402_1005Metric; MPN CC0402KRX7R9BB471
C51, C52, C53, C54: C_4u7_0603; C_0603_1608Metric; MPN C1608X5R1V475KT000E
FB7: FB_120Z_3A_Murata-BLM18SG_0603; FB_0603_1608Metric; MPN BLM18SG121TN1D
FB8, FB9, FB10, FB11: FB_1kZ_0.8A_WE-CBF_0805; FB_0805_2012Metric; MPN 742792096
FB12: FB_600Z_0.5A_Murata-BLM18AG_0603; FB_0603_1608Metric; MPN BLM18AG601SN1D
IC3: TLV73325PDBVR; SOT-23-5; MPN TLV73325PDBVR
IC4: TLV74312PDBVR; SOT-23-5; MPN TLV74312PDBVR
J4: HDMI-D_Molex_467651001; HDMI_Micro-D_Molex_46765-1xxx; MPN 467651001
J5: 5051101992; MPN 5051101992; not fitted
R14, R15, R18, R19, R20, R21: R_0R_0603; R_0603_1608Metric; MPN CR0603-J/-000ELF
R16, R22, R23, R24, R25: R_10k_0402; R_0402_1005Metric; Tolerance 1%; MPN CR0402-FX-1002GLF
R17: R_2k_0402; R_0402_1005Metric; Tolerance 1%; MPN 0402WGF2001TCE
R26: R_22R_0402; R_0402_1005Metric; Tolerance 1%; MPN 0402WGF220JTCE
TP5, TP6, TP7, TP8: TP_0.75mm_SMD; TP_SMD_0.75mm
U4: TC358743XBG; BGA-64_8x8_6.0x6.0mm; MPN TC358743XBG
U5: TPD8S009DSMR; R-PDSO-N15; MPN TPD8S009DSMR
U6: PCA9517ADP; MSOP-8_3x3mm_P0.65mm; MPN PCA9517ADP,118
Y2: Oscillator_27MHz_HELE_SSI027000E3CH; Oscillator_SMD_TXC_7C_5x3.2x1.2mm; MPN SSI027000E3CH

Connections:
+3V3: C35.2, C36.2, C37.1, C40.2, C41.2, FB12.1, IC3.1 (VIN), IC3.3 (EN), IC4.1 (VIN), IC4.3 (EN), R16.2, R19.2, R20.2, R21.2, R22.2, R23.2, U5.13 (VCC), U5.15 (VCC), U6.1 (Vref1); also elsewhere on the board
+5V: C45.2, R24.2, R25.2, U6.8 (Vref2); also elsewhere on the board
/Channel 2/CH2_AVDD33: C34.2, R17.2, R21.1, U4.B1 (AVDD33), U4.F3 (AVDD33)
/Channel 2/CH2_REFCLK: C46.2, R26.2, U4.H5 (REFCLK)
/Channel 2/CH2_~RST: R16.1, U4.G5 (~RESET)
/Channel 2/DUMMY2: J4.2 (UTILITY/HEAC+), J5.14
/Channel 2/HDMI2_CEC: J4.15 (CEC), J5.13, U4.G1 (CEC)
/Channel 2/HDMI2_CLK_N: J4.14 (CK-), J5.12, U4.C2 (HDMIC_N), U5.12 (D3-)
/Channel 2/HDMI2_CLK_P: J4.12 (CK+), J5.10, U4.C1 (HDMIC_P), U5.10 (D3+)
/Channel 2/HDMI2_D0_N: J4.11 (D0-), J5.9, U4.D2 (HDMID0_N), U5.9 (D2-)
/Channel 2/HDMI2_D0_P: J4.9 (D0+), J5.7, U4.D1 (HDMID0_P), U5.7 (D2+)
/Channel 2/HDMI2_D1_N: J4.8 (D1-), J5.6, U4.E2 (HDMID1_N), U5.6 (D1-)
/Channel 2/HDMI2_D1_P: J4.6 (D1+), J5.4, U4.E1 (HDMID1_P), U5.4 (D1+)
/Channel 2/HDMI2_D2_N: J4.5 (D2-), J5.3, U4.F2 (HDMID2_N), U5.3 (D0-)
/Channel 2/HDMI2_D2_P: J4.3 (D2+), J5.1, U4.F1 (HDMID2_P), U5.1 (D0+)
/Channel 2/HDMI2_DDC_SCL: J4.17 (SCL), J5.15, R24.1, U6.7 (SCL2)
/Channel 2/HDMI2_DDC_SCL_3V3: R23.1, U4.H3 (DDC_SCL), U6.2 (SCL1)
/Channel 2/HDMI2_DDC_SDA: J4.18 (SDA), J5.16, R25.1, U6.6 (SDA2)
/Channel 2/HDMI2_DDC_SDA_3V3: R22.1, U4.G3 (DDC_SDA), U6.3 (SDA1)
/Channel 2/HDMI2_HPD: J4.1 (HPD/HEAC-), J5.19, R14.2
/Channel 2/HDMI2_HPDI: R15.2, U4.H2 (HPDI)
/Channel 2/HDMI2_HPDO: TP7.1, U4.H1 (HPDO)
/Channel 2/HDMI2_POWER: J4.19 (+5V), J5.18, R14.1, R15.1
CH2_1V2: C43.2, FB9.2, FB10.2, FB11.2, IC4.5 (VOUT)
CH2_2V5: C42.2, FB8.2, IC3.5 (VOUT)
CSI3_CLK_N: U4.C7 (CSIC_N); also elsewhere on the board
CSI3_CLK_P: U4.C8 (CSIC_P); also elsewhere on the board
CSI3_D1_N: U4.E7 (CSID0_N); also elsewhere on the board
CSI3_D1_P: U4.E8 (CSID0_P); also elsewhere on the board
CSI3_D2_N: U4.D7 (CSID1_N); also elsewhere on the board
CSI3_D2_P: U4.D8 (CSID1_P); also elsewhere on the board
CSI3_D3_N: U4.B7 (CSID2_N); also elsewhere on the board
CSI3_D3_P: U4.B8 (CSID2_P); also elsewhere on the board
CSI3_D4_N: U4.A7 (CSID3_N); also elsewhere on the board
CSI3_D4_P: U4.A8 (CSID3_P); also elsewhere on the board
GND: C24.1, C25.1, C26.1, C31.1, C32.1, C33.1, C34.1, C35.1, C36.1, C37.2, C38.1, C39.1, C40.1, C41.1, C42.1, C43.1, C44.1, C45.1, C46.1, C47.2, C48.2, C49.2, C50.2, C51.1, C52.1, C53.1, C54.1, FB7.1, IC3.2 (GND), IC4.2 (GND), J4.4 (D2S), J4.7 (D1S), J4.10 (D0S), J4.13 (CKS), J4.16 (GND), J5.2, J5.5, J5.8, J5.11, J5.17, U4.A2 (GND), U4.A3 (VPGM), U4.C4 (GND), U4.C5 (GND), U4.D4 (GND), U4.D5 (GND), U4.D6 (GND), U4.E3 (GND), U4.E4 (GND), U4.E5 (TEST), U4.E6 (GND), U4.H8 (GND), U5.2 (GND), U5.5 (GND), U5.8 (GND), U5.11 (GND), U6.4 (GND), Y2.2 (GND); also elsewhere on the board
I2C3_SCL: U4.H4 (I2C_SCL); also elsewhere on the board
I2C3_SDA: U4.G4 (I2C_SDA); also elsewhere on the board
unnamed: C31.2, R18.1, U4.C3 (VDDC2), U4.F5 (VDDC2)
unnamed: C48.1, C52.2, FB9.1, U4.B2 (AVDD12), U4.D3 (AVDD12)
unnamed: C49.1, C53.2, FB10.1, U4.C6 (VDD_MIPI), U4.F6 (VDD_MIPI)
unnamed: FB7.2, J4.SH
unnamed: TP6.1, U4.H6 (EDID_SCL)
unnamed: TP5.1, U4.G6 (EDID_SDA)
unnamed: C47.1, C51.2, FB8.1, U4.B5 (AVDD25)
unnamed: R17.1, U4.A1 (REXT)
unnamed: C50.1, C54.2, FB11.1, R18.2, U4.G2 (VDDC1)
unnamed: C32.2, R19.1, U4.F4 (VDDIO1)
unnamed: C33.2, R20.1, U4.H7 (VDDIO2)
unnamed: C24.2, U4.A4 (BIASDA)
unnamed: C25.2, U4.A5 (DAOUT)
unnamed: C26.2, U4.B6 (PCKIN)
unnamed: TP8.1, U6.5 (EN)
unnamed: C38.2, C39.2, FB12.2, Y2.1 (EN), Y2.4 (VDD)
unnamed: C44.2, R26.1, Y2.3 (OUT)

Notes on the sheet:
1V2
1V8-3V3
9mA
3V3
83mA
Video Interfaces
1.2V
13mA
27MHz Oscillator
23mA
76mA
Connectors
2V5
2.5V
CH2_INT
Converter IC
Power
Voltage Regulators
Misc
I2C Level Shifter
88mA

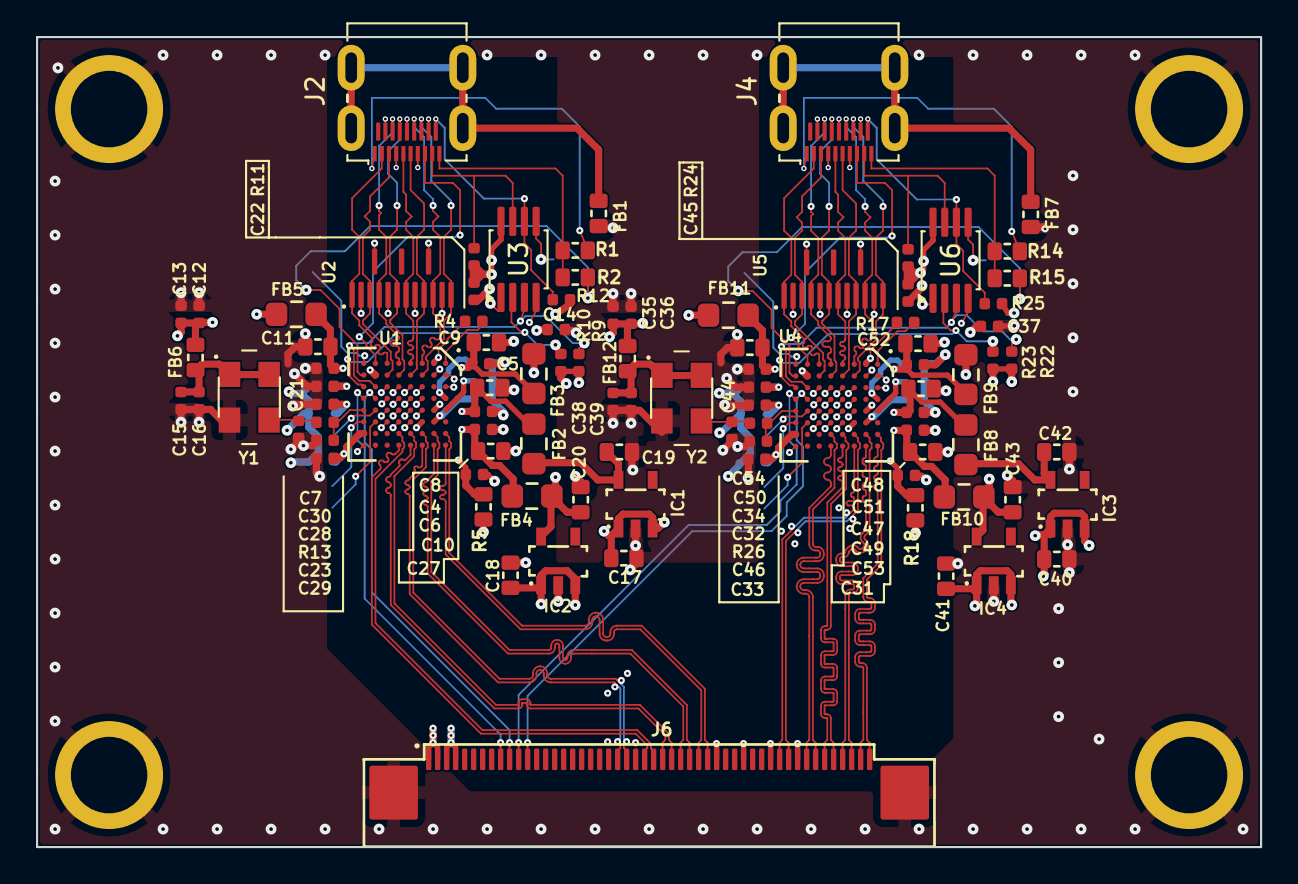
[picture p16: board antmicro-hdmi-mipi-bridge-hw.kicad_pcb from above]

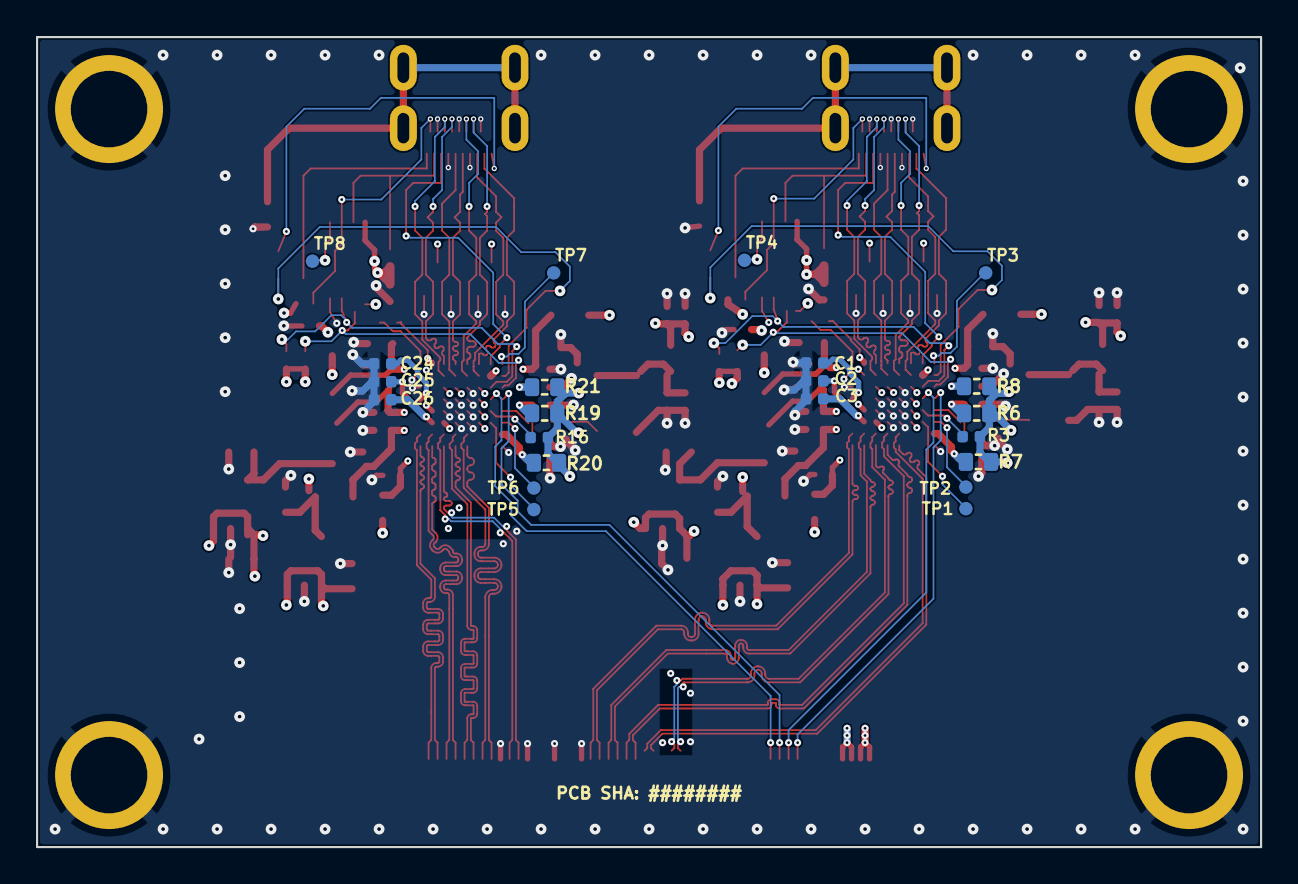
[picture p17: board antmicro-hdmi-mipi-bridge-hw.kicad_pcb from below]

Board: 4 copper layers, 68.0 x 45.0 mm, 121 parts (26 on the bottom side), 105 nets.
