mhamann/hdmi-mipi-bridge/(commit log)

2026-10-27 Upgrade project files to KiCad 10 format
    Pure format upgrade with kicad-cli 10.0.7 (pcb/sch upgrade --force);
    no design changes. DRC/ERC results are identical to the KiCad 7 files
    apart from KiCad 10's new footprint/symbol field-mismatch warnings.
    [antmicro-hdmi-mipi-bridge-hw.kicad_pcb, antmicro-hdmi-mipi-bridge-hw.kicad_sch, channel1.kicad_sch, channel2.kicad_sch, csi.kicad_sch]
2026-10-27 Switch to micro-HDMI and widely-available parts for JLCPCB
    - J2/J4: HDMI-A Molex 471511001 -> micro-HDMI (Type D) Molex 467651001,
    KiCad stock footprint. Symbol renumbered to the Type D pinout.
    D2/D0 fan out on F.Cu; D1/CLK drop to B.Cu via 0.15/0.30 mm vias in
    front of the inner pad row and rejoin the original routing, so the
    ESD-to-TC358743 routing is unchanged. Intra-pair skew re-matched to
    0.000 mm on all 8 pairs. DDC/HPD/CEC/5V re-routed for the new pinout.
    - U3/U6: PCA9517ATP (HWSON8) -> PCA9517ADP (MSOP-8, same die), moved
    1.45 mm up into the space freed by the smaller connector.
    - Y1/Y2: TXC 7C-27.000MBB-T -> HELE SSI027000E3CH; pads moved to the
    datasheet land (+-1.27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
    [antmicro-hdmi-mipi-bridge-hw.kicad_pcb, channel1.kicad_sch, channel2.kicad_sch, csi.kicad_sch]
2026-10-27 Add JLCPCB production outputs and validation reports
    Gerbers/drill, JLC BOM + CPL, order notes, DRC/ERC reports (project
    rules and JLC 4-layer capability rules), TMDS length report and
    gerber renders. The gerber zip itself is gitignored; zip
    production/gerbers/ for upload.
    [BOM-hdmi-mipi-bridge.csv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]
